nickmolo/ECE477/readme.MD

#Senior Design Project for Purdue ECE477
The following code is for a fabricated smart-watch for Senior design. Code in this repo is based off of various libraries including our own, such as the Adafruit Graphics Libraries for our SSD1351 display.

Midterm Design Review Presentation 
https://docs.google.com/presentation/d/1fQvJexct02s5zMMklutLdLCyOUqHS_1bk4CB7YSZFS4/edit?usp=sharing

Final Design Review Presentation
https://docs.google.com/presentation/d/1uoW5v5YpZROXi00Bag2v_5JE344Z9XPI0Cu_86e-bGs/edit?usp=sharing

Video!
https://www.youtube.com/watch?v=YeXBOrRXs24
