nickmolo/ECE477/Hardware/Images/Bluetooth.png

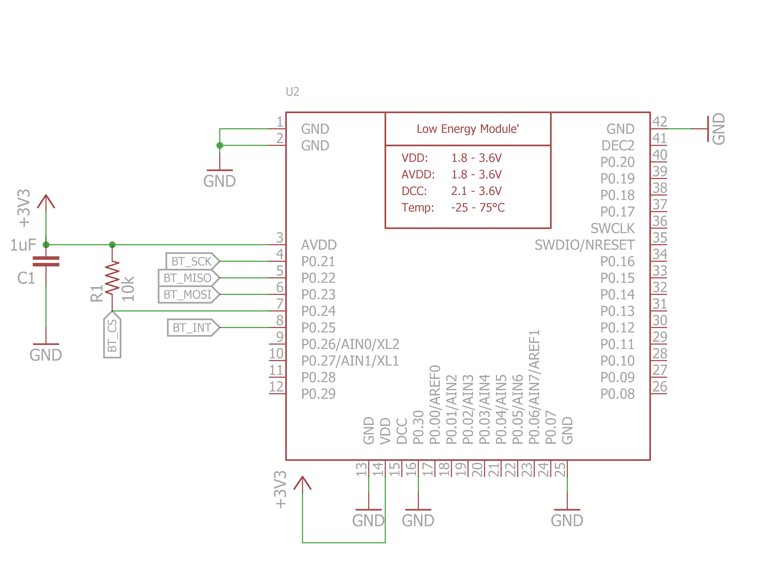
Hardware/Images/Bluetooth.png
