nickmolo/ECE477/Hardware/Images/Gesture.png

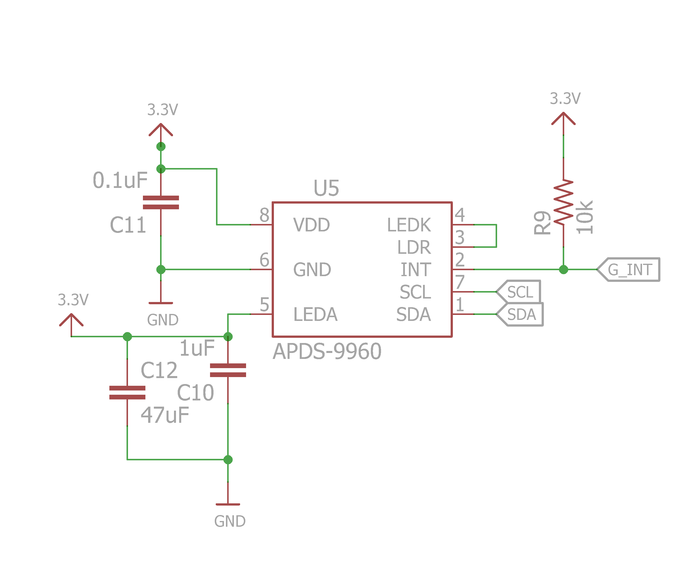
Hardware/Images/Gesture.png
