nickmolo/ECE477/Hardware/Images/IMU.png

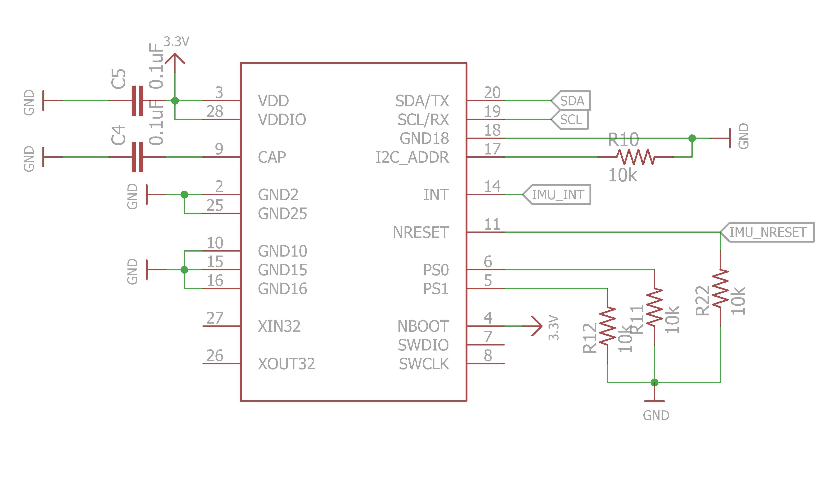
Hardware/Images/IMU.png
