nickmolo/ECE477/Hardware/Images/Microcontroller1.png

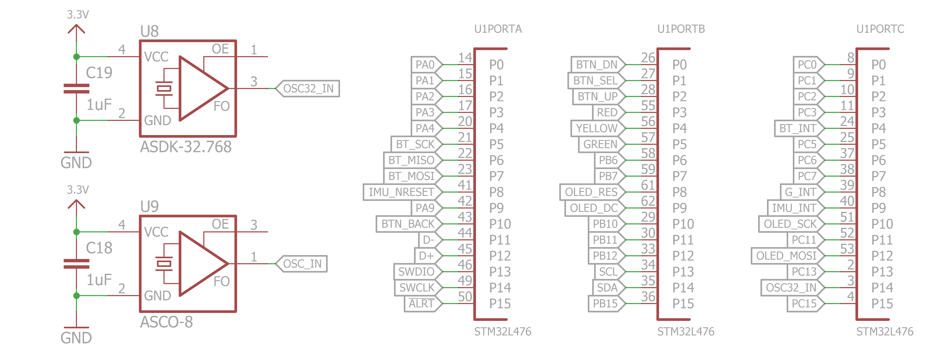
Hardware/Images/Microcontroller1.png
