nickmolo/ECE477/Hardware/Images/Microcontroller2.png

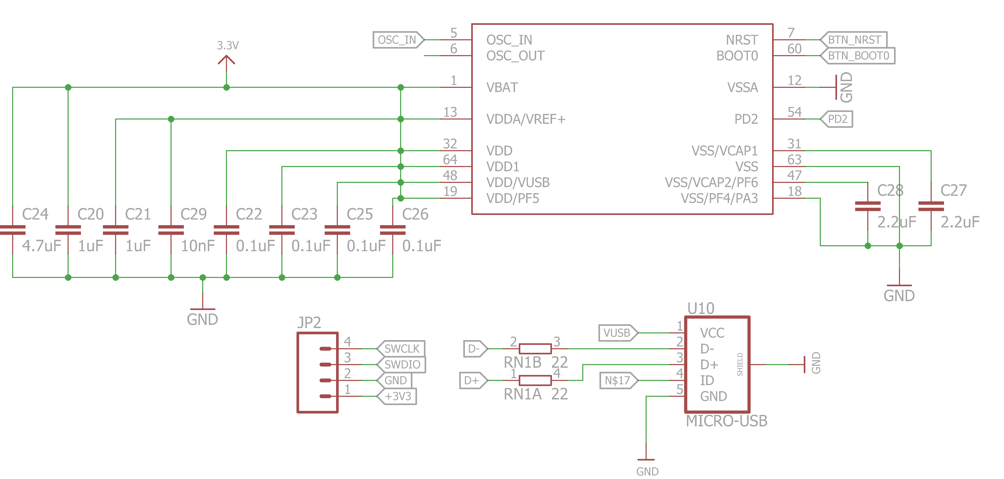
Hardware/Images/Microcontroller2.png
