nickmolo/ECE477/Hardware/Images/Microcontroller.png

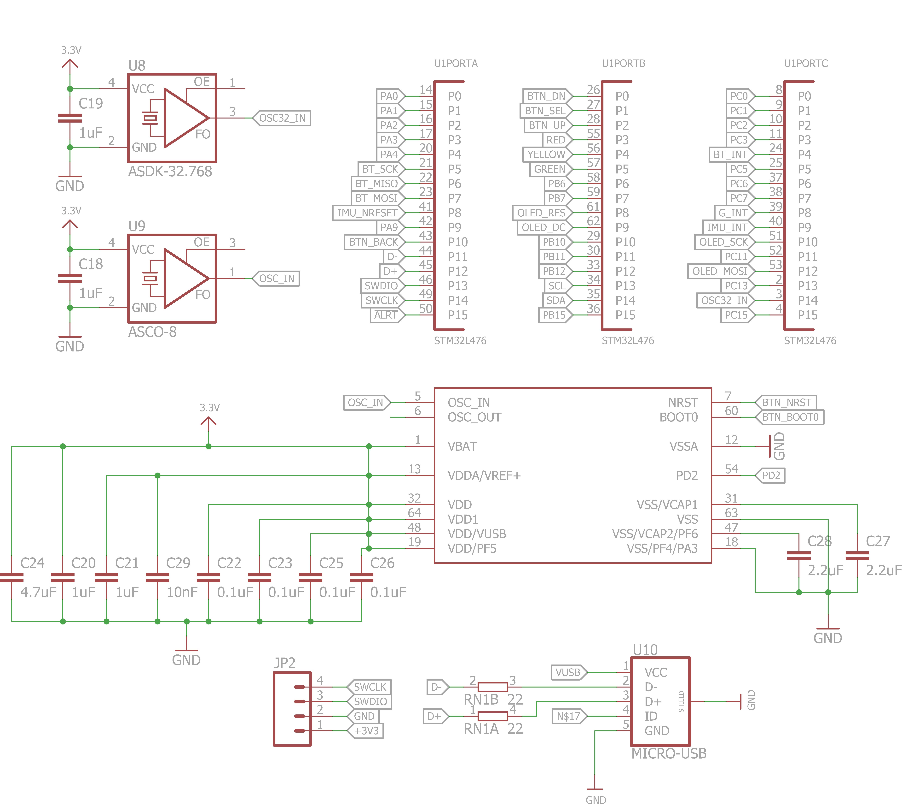
Hardware/Images/Microcontroller.png
