nickmolo/ECE477/Hardware/Images/MicroPinouts.PNG

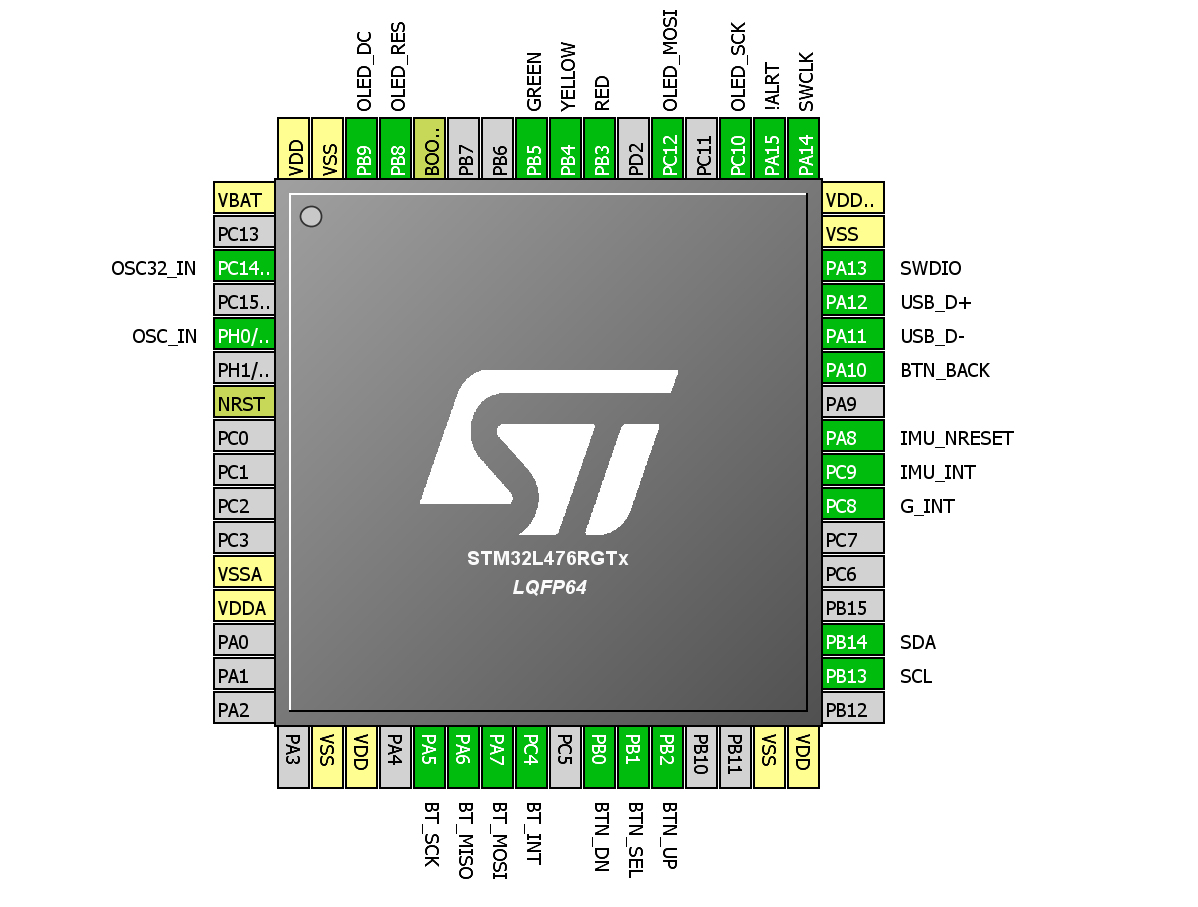
Hardware/Images/MicroPinouts.PNG
