nickmolo/ECE477/Hardware/Images/Misc.png

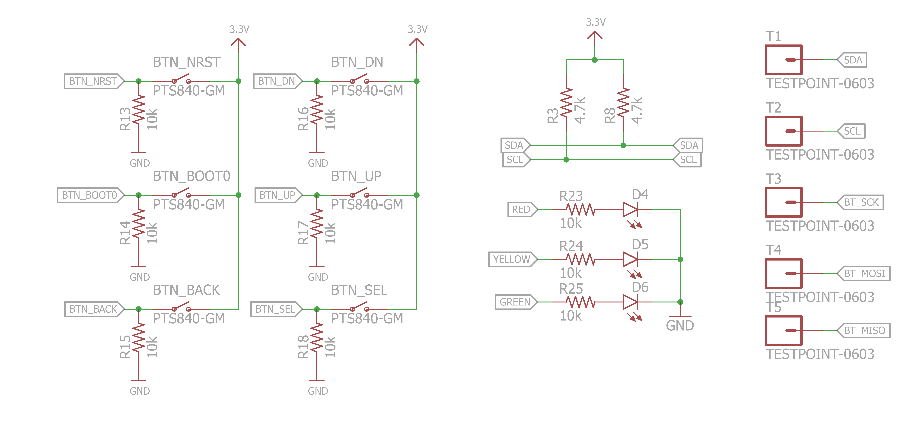
Hardware/Images/Misc.png
