nickmolo/ECE477/Hardware/Images/pcb.png

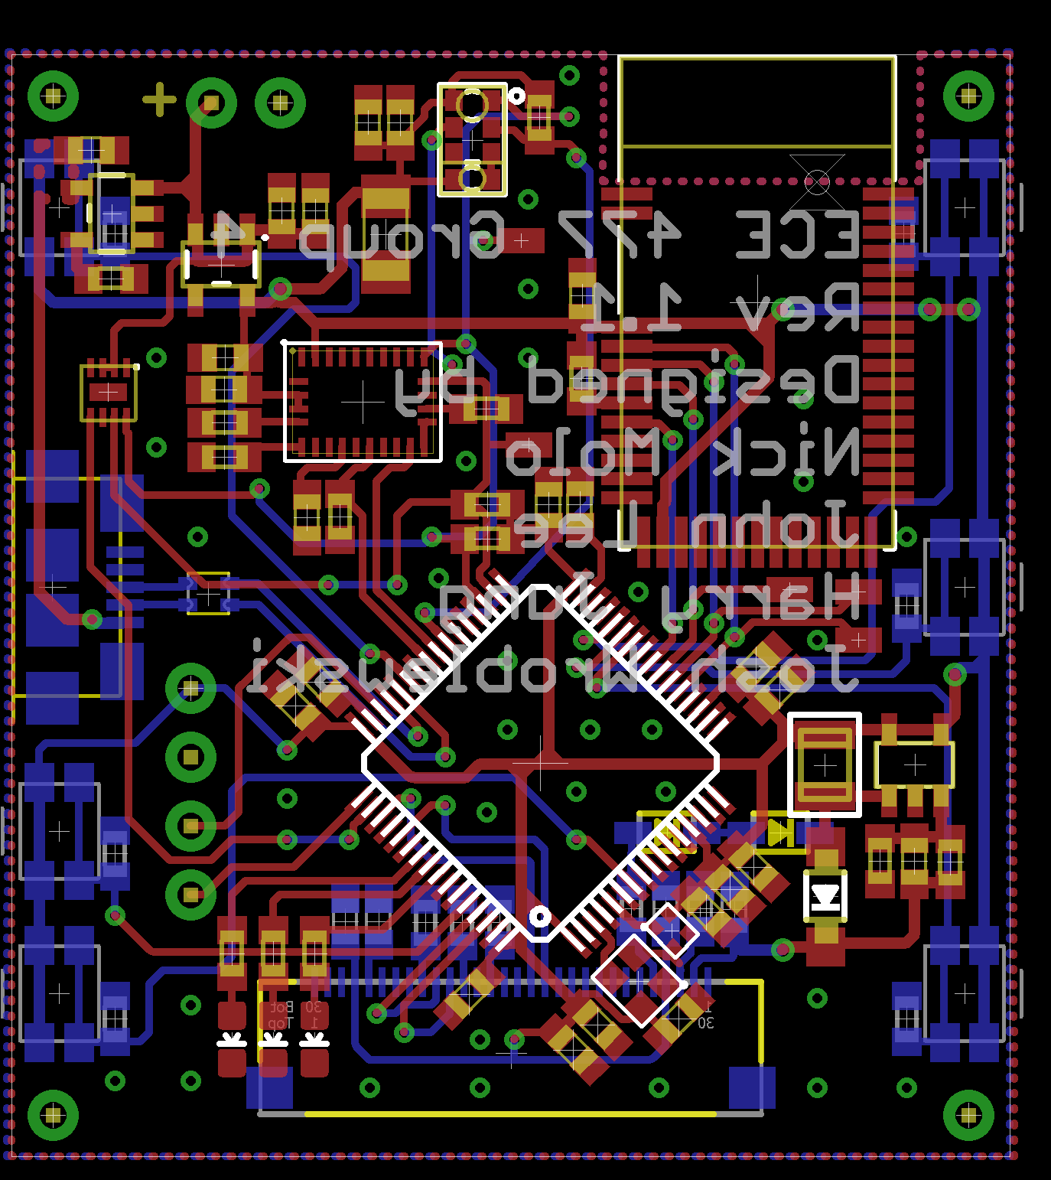
Hardware/Images/pcb.png
