nickmolo/ECE477/Hardware/Images/pcb_bot.png

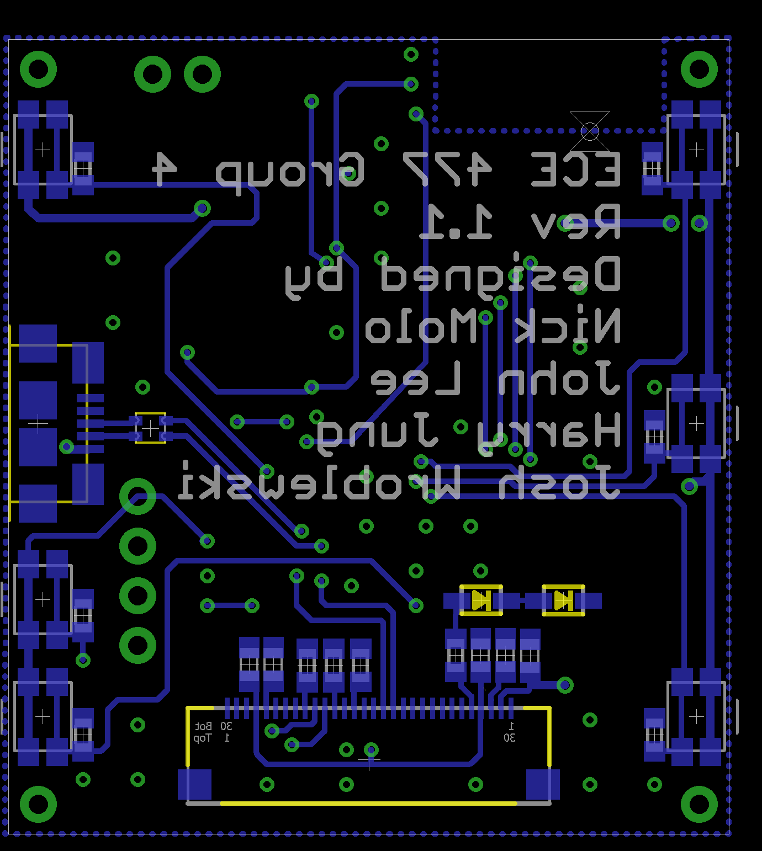
Hardware/Images/pcb_bot.png
