nickmolo/ECE477/Hardware/Images/pcb_top.png

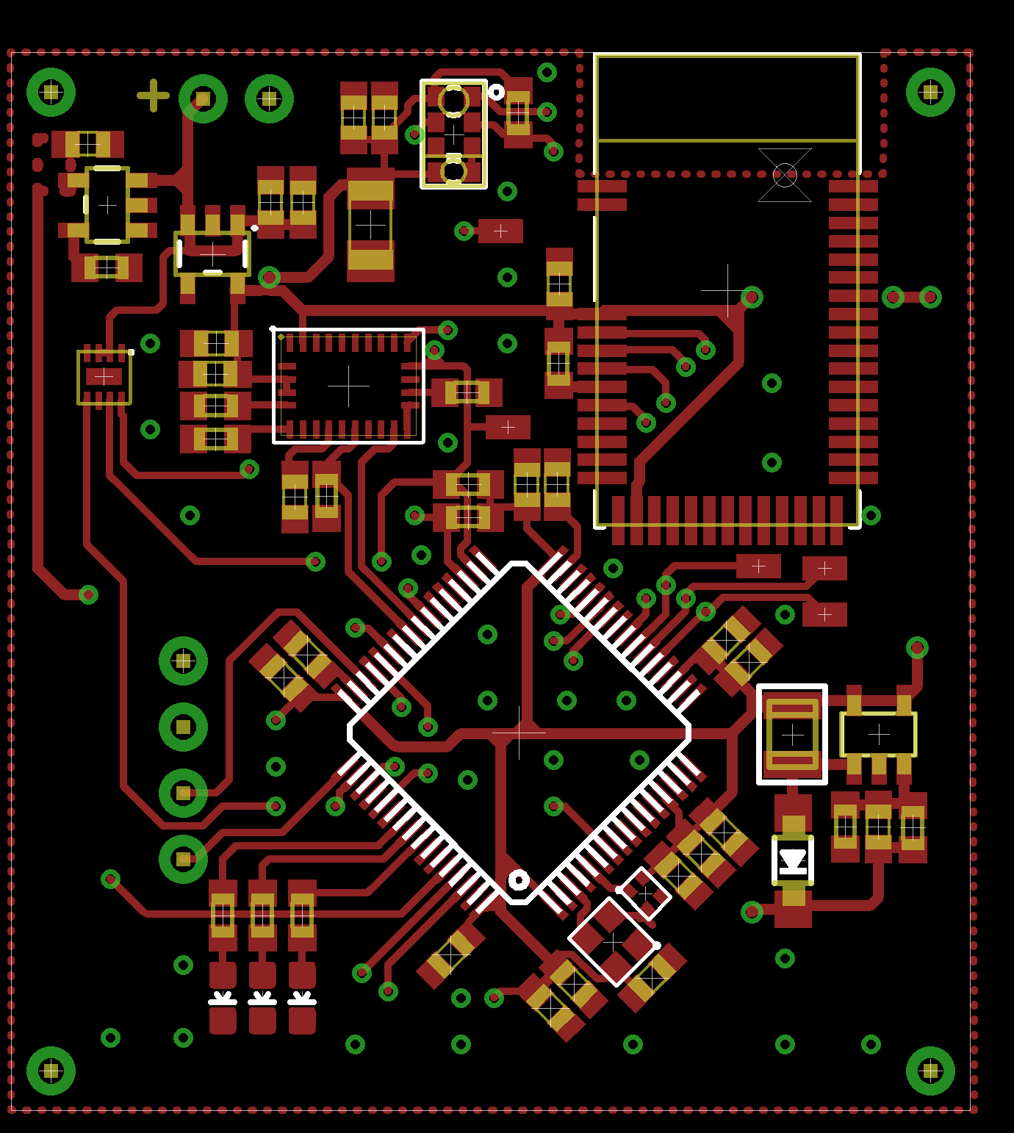
Hardware/Images/pcb_top.png
