nickmolo/ECE477/Hardware/Images/Power.png

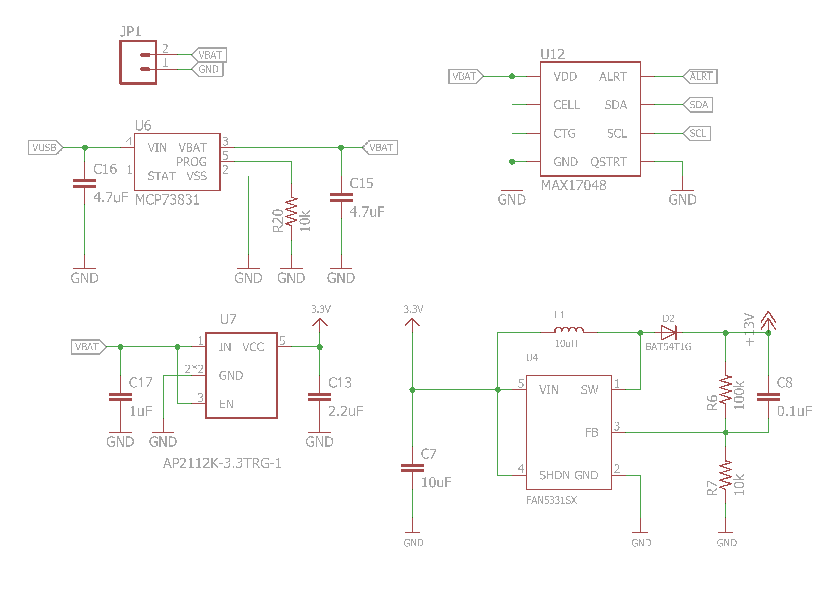
Hardware/Images/Power.png
