nickmolo/ECE477/Hardware/Images/Screen.png

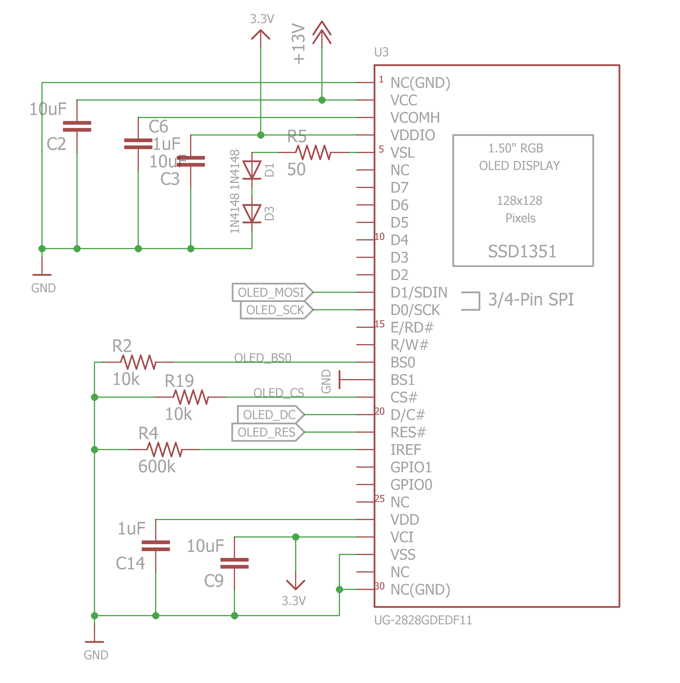
Hardware/Images/Screen.png
