nickmolo/ECE477/Hardware/BOM.xlsx

Qty | Qty x6 | Qty to Buy | Value | Device | Package | Parts | Description | Supplier | Part Number
6 | 36 | 40 | PTS840-GM | PTS840-GM | PTS840-GM | BTN_BACK, BTN_BOOT0, BTN_DN, BTN_NRST, BTN_SEL, BTN_UP | Button | Digikey | CKN10507CT-ND
8 | 48 | 100 | 1uF | C-EUC0603 | C0603 | C1, C3, C10, C14, C17, C18, C19, C20, C21 | Capacitor | Digikey | 445-1604-1-ND
1 | 6 | 10 | 47uF | C-EUC1206 | C1206 | C12 | Capacitor | Digikey | 587-1780-1-ND
3 | 18 | 30 | 2.2uF | C-EUC0603 | C0603 | C13, C27, C28 | Capacitor | Digikey | 1276-1188-1-ND
3 | 18 | 100 | 4.7uF | C-EUC0603 | C0603 | C15, C16, C24 | Capacitor | Digikey | 1276-2087-1-ND
4 | 24 | 30 | 10uF | C-EUC0603 | C0603 | C2, C6, C7, C9 | Capacitor | Digikey | 445-9065-1-ND
1 | 6 | 10 | 10nF | C-EUC0603 | C0603 | C29 | Capacitor | Digikey | 445-1304-1-ND
8 | 48 | 100 | 0.1uF | C-EUC0603 | C0603 | C4, C5, C8, C11, C22, C23, C25, C26 | Capacitor | Digikey | 1276-1936-1-ND
2 | 12 | 20 | 1N4148 | DIODESOD-323 | SOD-323 | D1, D3 | Diode | Digikey | 1N4148WFL-G3-08GICT-ND
1 | 6 | 10 | BAT54T1G | DIODESOD-123 | SOD-123 | D2 | Diode | Digikey | BAT54T1GOSCT-ND
1 | 6 |  |  | M02PTH | 1X02 | JP1 | Standard 2-pin 0.1 " | Digikey
1 | 6 | 10 | 10uH | INDUCTOR | INDUCTOR_1007 | L1 | Inductors | Digikey | 587-1936-1-ND
17 | 102 | 500 | 10k | R-US_R0603 | R0603 | R1, R2, R7, R9, R10, R11, R12, R13, R14, R15, R16, R17, R18, R19, R20, R21, R22 | Resistor | Digikey | P10KGCT-ND50
2 | 12 | 100 | 4.7k | R-US_R0603 | R0603 | R3, R8 | Resistor | Digikey | P4.7KGCT-ND
1 | 6 | 50 | 600k | R-US_R0603 | R0603 | R4 | Resistor | Digikey | P604KHCT-ND
1 | 6 | 50 | 50 | R-US_R0603 | R0603 | R5 | Resistor | Digikey | P49.9HCT-ND
1 | 6 | 50 | 100k | R-US_R0603 | R0603 | R6 | Resistor | Digikey | P100KGCT-ND
1 | 6 | 10 | 22 | 2R-NEXBV4V | EXBV4V | RN1 | Array Chip Resistor | Digikey | Y2220CT-ND
1 | 6 | 5 | STM32L476 | STM32L476 | TQFP64-10X10 | U1 | Micro Controller | Digikey | 497-15877-ND
1 | 6 | 10 | MICRO-USB | MICRO-USB | MICRO-USB | U10 | USB Connector | Digikey | 609-4613-1-ND
1 | 6 |  | BNO055 | BNO055 | LGA28 | U11 | IMU | Mouser | 262-BNO055
1 | 6 |  |  | NRF51822_MODULE_MDBT40 | BLE_MODULE_RAYTAC_MDBT40 | U2 | nRF51822 Bluetooth | Adafruit | 2633
1 | 6 |  | UG-2828GDEDF11 | DISP_OLED_UG-2828GDEDF11BOTTOM | FPC_XF2M-3015-1A | U3 | OLED Display + zif!!! | BuyDisplay | ER-OLED015-1C
1 | 6 | 10 | FAN5331SX | FAN5331 | SOT23-5$1 | U4 | Boost Converter | Digikey | FAN5331SXCT-ND
1 | 6 | 5 | APDS-9960 | APDS-9960 | APDS-9960 | U5 | Gesture Sensor | Mouser | 630-APDS-9960
1 | 6 | 10 | MCP73831 | MCP73831 | SOT23-5 | U6 | Battery Charger | Digikey | MCP73831T-2ACI/OTCT-ND
1 | 6 | 10 | AP2112K-3.3TRG-1 | LDO-TPS78233 | SOT23-5 | U7 | Voltage Regulator | Digikey | AP2112K-3.3TRG1DICT-ND
1 | 6 | 6 | ASDK-32.768 | ASDK-32.768 | ASDK-32.768 | U8 | Oscillator | Digikey | 535-9999-1-ND
1 | 6 | 6 | ASCO-8 | ASCO-8 | ASCO-8 | U9 | Oscillator | Digikey | 535-12077-1-ND
5 | 30 | 30 |  | Test Point | 603 | T1, T2, T3, T4, T5 | Test point | Digikey | 571-1625854-3
5 | 30 |  |  | MAX17048G | TDFN-8 | U12 | Battery Monitor | Mouser | 700-MAX17048G+
3 | 18 |  | 82 | Resistor | 603 | R23, R24, R25 | Resistor | Digikey | P82GCT-ND
1 | 6 |  | RED | LED | 603 | D4 | Red LED | Digikey | 475-2506-1-ND
1 | 6 |  | YELLOW | LED | 603 | D5 | Yellow LED | Digikey | 475-1196-1-ND
1 | 6 |  | GREEN | LED | 603 | D6 | Green LED | Digikey | 475-2709-1-ND
