nickmolo/ECE477/Hardware/SmartWatch/SmartWatch.dxf

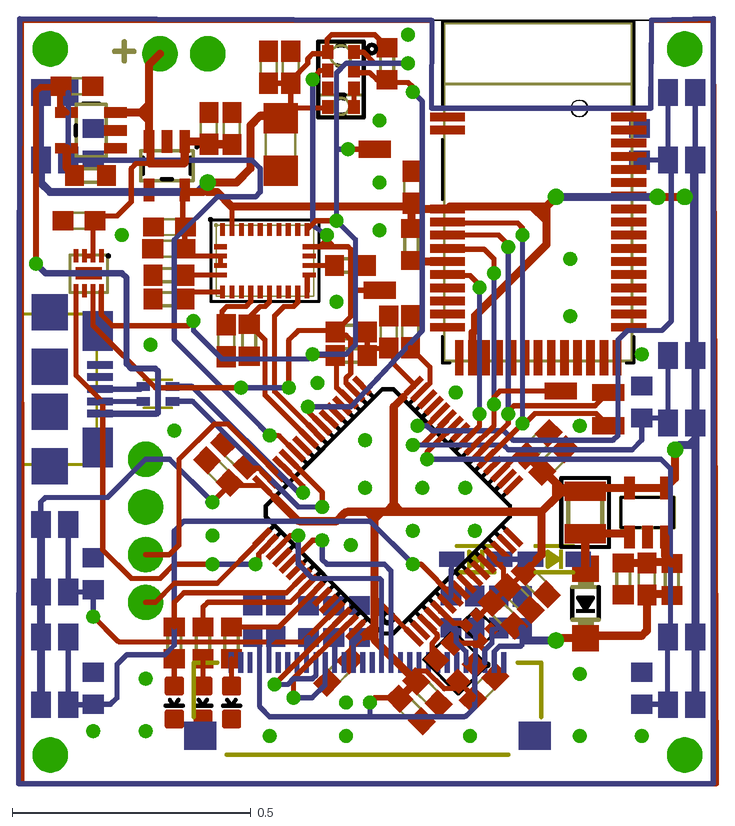
[picture p18: CAD file, 2015-12-07]
Hardware/SmartWatch/SmartWatch.dxf
1.47 x 1.61
