nickmolo/ECE477/Hardware/SmartWatch/SmartWatch.pdf

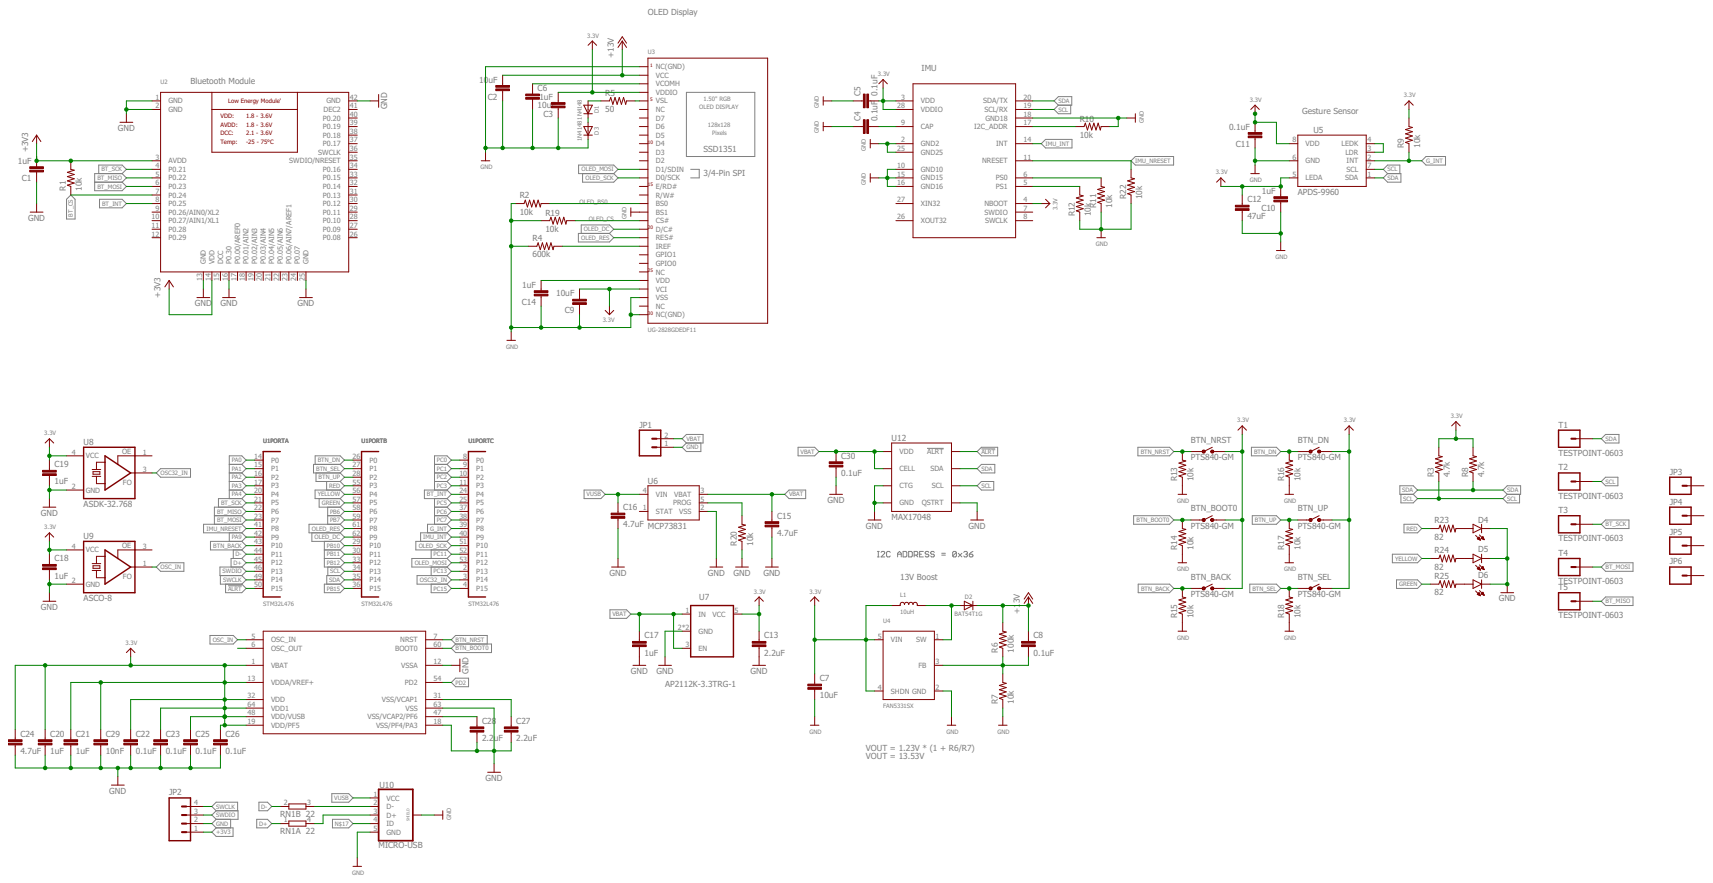
[picture p19: page 1]

Gesture Sensor 1.50" RGB OLED DISPLAY
