nickmolo/ECE477/Hardware/SmartWatch/SmartWatch.brd

## EAGLE design Hardware/SmartWatch/SmartWatch.brd (2015-10-23)

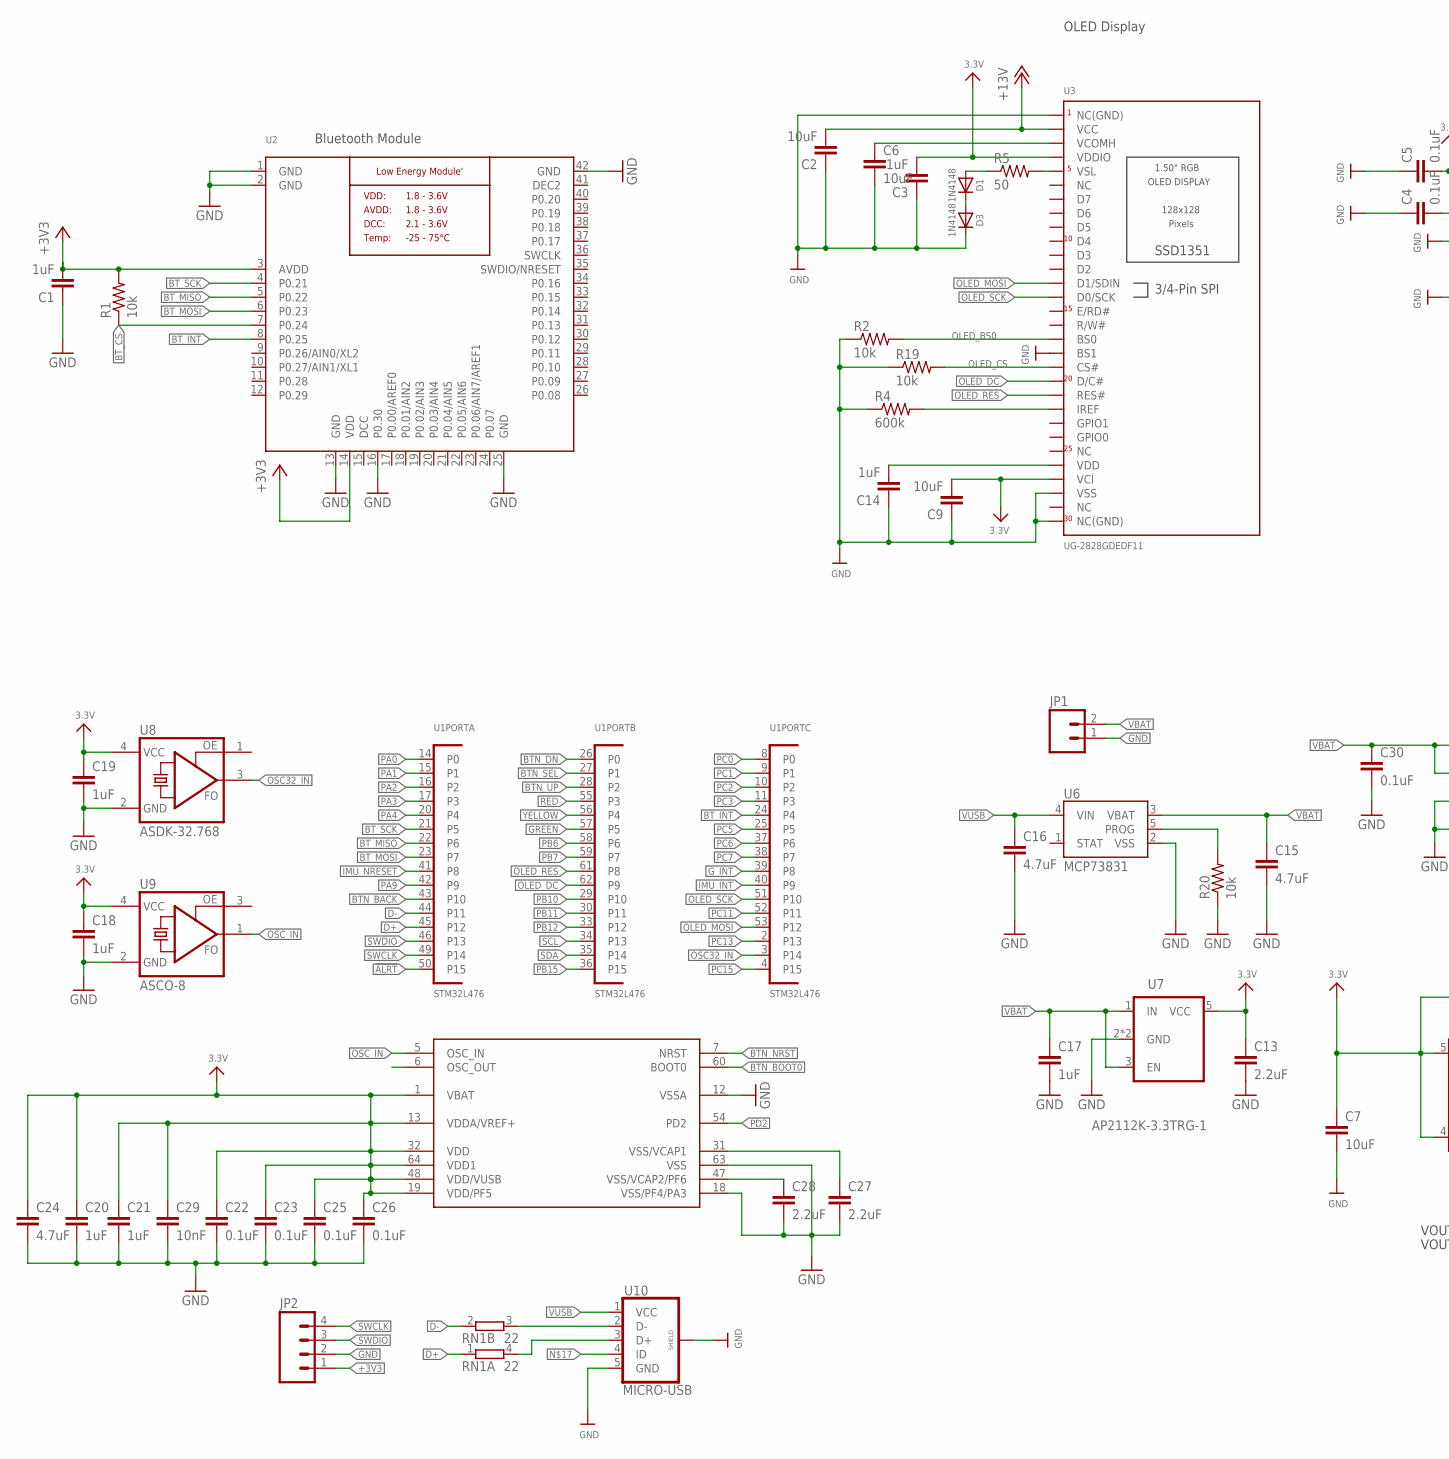
[picture p20: schematic SmartWatch.sch, part in row 1, column 1]

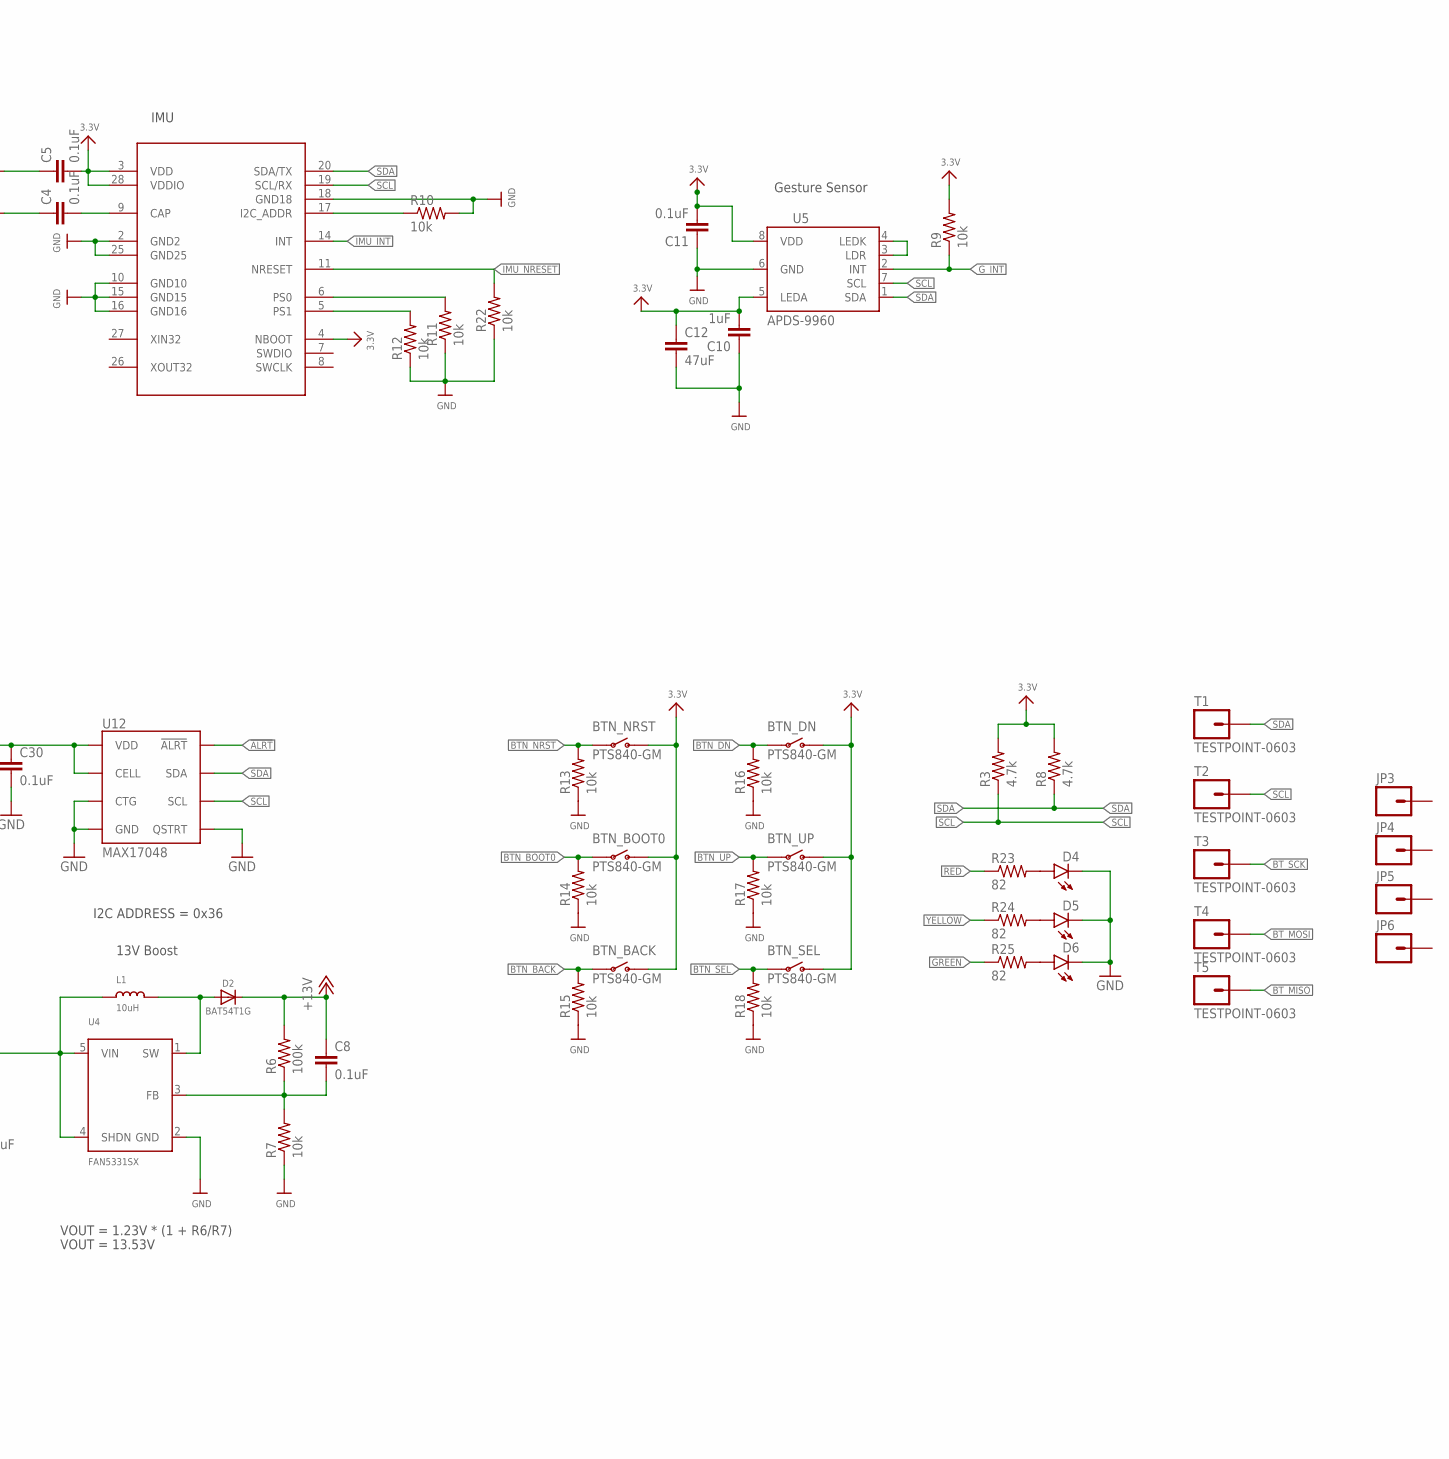
[picture p21: schematic SmartWatch.sch, part in row 1, column 2]

Parts:
BTN_BACK: PTS840-GM
BTN_BOOT0: PTS840-GM
BTN_DN: PTS840-GM
BTN_NRST: PTS840-GM
BTN_SEL: PTS840-GM
BTN_UP: PTS840-GM
C1, C3, C10, C14, C17, C18, C19, C20, C21: 1uF; C0603
C2, C6, C7, C9: 10uF; C0603
C4, C5, C8, C11, C22, C23, C25, C26, C30: 0.1uF; C0603
C12: 47uF; C1206
C13, C27, C28: 2.2uF; C0603
C15, C16, C24: 4.7uF; C0603
C29: 10nF; C0603
D1, D3: 1N4148; SOD-323
D2: BAT54T1G; SOD-123
D4, D5, D6: LED0603; LED-0603
JP1: M021X02_NO_SILK; 1X02_NO_SILK
JP2: M04NO_SILK_ALL_ROUND; 1X04_NO_SILK_ALL_ROUND
JP3, JP4, JP5, JP6: M01PTH_NO_SILK_YES_STOP; 1X01_NO_SILK
L1: 10uH; INDUCTOR_1007
R1, R2, R7, R9, R10, R11, R12, R13, R14, R15, R16, R17, R18, R19, R20, R22: 10k; R0603
R3, R8: 4.7k; R0603
R4: 600k; R0603
R5: 50; R0603
R6: 100k; R0603
R23, R24, R25: 82; R0603
RN1: 22; EXBV4V
T1, T2, T3, T4, T5: TESTPOINT-0603
U1: STM32L476; TQFP64-10X10
U2: NRF51822_MODULE_MDBT40; BLE_MODULE_RAYTAC_MDBT40
U3: UG-2828GDEDF11; FPC_XF2M-3015-1A
U4: FAN5331SX; SOT23-5$1
U5: APDS-9960
U6: MCP73831; SOT23-5
U7: AP2112K-3.3TRG-1; SOT23-5
U8: ASDK-32.768
U9: ASCO-8
U10: MICRO-USB
U11: BNO055; LGA28
U12: MAX17048; DFN-8

Connections:
13V: C2.2, C8.1, D2.C, R6.2, U3.P$2 (VCC)
!ALRT: U1.50 (P15), U12.P$5 (!ALRT)
+3V3: BTN_BACK.3 (34), BTN_BACK.4 (34), BTN_BOOT0.3 (34), BTN_BOOT0.4 (34), BTN_DN.3 (34), BTN_DN.4 (34), BTN_NRST.3 (34), BTN_NRST.4 (34), BTN_SEL.3 (34), BTN_SEL.4 (34), BTN_UP.3 (34), BTN_UP.4 (34), C1.2, C3.2, C5.2, C7.1, C9.2, C10.2, C11.2, C12.1, C13.1, C18.1, C19.1, C20.1, C21.1, C22.1, C23.1, C24.1, C25.1, C26.1, C29.1, JP2.1, L1.P$1 (1), R1.2, R3.2, R8.2, R9.2, U1.1 (VBAT), U1.13 (VDDA/VREF+), U1.19 (VDD/PF5), U1.32 (VDD), U1.48 (VDD/VUSB), U1.64 (VDD1), U2.3 (AVDD), U2.14 (VDD), U3.P$4 (VDDIO), U3.P$27 (VCI), U4.4 (SHDN), U4.5 (VIN), U5.5 (LEDA), U5.8 (VDD), U7.5 (VCC), U8.4 (VCC), U9.4 (VCC), U11.3 (VDD), U11.4 (NBOOT), U11.28 (VDDIO)
BTN_BACK: BTN_BACK.1 (12), BTN_BACK.2 (12), R15.2, U1.43 (P10)
BTN_BOOT0: BTN_BOOT0.1 (12), BTN_BOOT0.2 (12), R14.2, U1.60 (BOOT0)
BTN_DN: BTN_DN.1 (12), BTN_DN.2 (12), R16.2, U1.26 (P0)
BTN_NRST: BTN_NRST.1 (12), BTN_NRST.2 (12), R13.2, U1.7 (NRST)
BTN_SEL: BTN_SEL.1 (12), BTN_SEL.2 (12), R18.2, U1.27 (P1)
BTN_UP: BTN_UP.1 (12), BTN_UP.2 (12), R17.2, U1.28 (P2)
BT_CS: R1.1, U2.7 (P0.24)
BT_INT: U1.24 (P4), U2.8 (P0.25)
BT_MISO: T5.1, U1.22 (P6), U2.5 (P0.22)
BT_MOSI: T4.1, U1.23 (P7), U2.6 (P0.23)
BT_SCK: T3.1, U1.21 (P5), U2.4 (P0.21)
D+: RN1.1, U1.45 (P12)
D-: RN1.2 (1), U1.44 (P11)
DCC: U2.15 (DCC)
DEC2: U2.41 (DEC2)
GND: C1.1, C2.1, C3.1, C4.1, C5.1, C6.2, C7.2, C9.1, C10.1, C11.1, C12.2, C13.2, C14.1, C15.2, C16.2, C17.2, C18.2, C19.2, C20.2, C21.2, C22.2, C23.2, C24.2, C25.2, C26.2, C27.2, C28.2, C29.2, C30.2, D3.C, D4.C, D5.C, D6.C, JP1.1, JP2.2, R2.1, R4.1, R7.1, R10.2, R11.1, R12.1, R13.1, R14.1, R15.1, R16.1, R17.1, R18.1, R19.1, R20.1, R22.1, U1.12 (VSSA), U1.18 (VSS/PF4/PA3), U1.63 (VSS), U2.1 (GND), U2.2 (GND), U2.13 (GND), U2.16 (P0.30), U2.25 (GND), U2.42 (GND), U3.P$1 (NC(GND)), U3.P$18 (BS1), U3.P$28 (VSS), U3.P$30 (NC(GND)), U4.2 (GND), U5.6 (GND), U6.2 (VSS), U7.2 (GND), U7.4 (GND), U8.2 (GND), U9.2 (GND), U10.5 (GND), U10.6 (SHIELD), U10.7 (SHIELD), U10.8 (SHIELD), U10.9 (SHIELD), U10.10 (SHIELD), U10.11 (SHIELD), U11.2 (GND2), U11.10 (GND10), U11.15 (GND15), U11.16 (GND16), U11.18 (GND18), U11.25 (GND25), U12.P$1 (CTG), U12.P$4 (GND), U12.P$6 (QSTRT), U12.P$9 (GND)
GREEN: R25.1, U1.57 (P5)
G_INT: R9.1, U1.39 (P8), U5.2 (INT)
ID: RN1.4 (2), U10.3 (D+)
IMU_INT: U1.40 (P9), U11.14 (INT)
IMU_NRESET: R22.2, U1.41 (P8), U11.11 (NRESET)
unnamed: R4.2, U3.P$22 (IREF)
unnamed: C14.2, U3.P$26 (VDD)
unnamed: R10.1, U11.17 (I2C_ADDR)
unnamed: C4.2, U11.9 (CAP)
unnamed: D2.A, L1.P$2 (2), U4.1 (SW)
unnamed: R5.2, U3.P$5 (VSL)
unnamed: D1.A, R5.1
unnamed: C8.2, R6.1, R7.2, U4.3 (FB)
unnamed: U5.3 (LDR), U5.4 (LEDK)
unnamed: RN1.3 (2), U10.2 (D-)
unnamed: D1.C, D3.A
unnamed: R12.2, U11.5 (PS1)
unnamed: R11.2, U11.6 (PS0)
unnamed: D4.A, R23.2
unnamed: D5.A, R24.2
unnamed: D6.A, R25.2
unnamed: C27.1, U1.31 (VSS/VCAP1)
unnamed: C28.1, U1.47 (VSS/VCAP2/PF6)
OLED_BS0: R2.2, U3.P$17 (BS0)
OLED_CS: R19.2, U3.P$19 (CS#)
OLED_DC: U1.62 (P9), U3.P$20 (D/C#)
OLED_MOSI: U1.53 (P12), U3.P$13 (D1/SDIN)
OLED_RES: U1.61 (P8), U3.P$21 (RES#)
OLED_SCK: U1.51 (P10), U3.P$14 (D0/SCK)
OSC32_IN: U1.3 (P14), U8.3 (FO)
OSC_IN: U1.5 (OSC_IN), U9.1 (FO)
PA0: U1.14 (P0)
PA1: U1.15 (P1)
PA2: U1.16 (P2)
PA3: U1.17 (P3)
PA4: U1.20 (P4)
PA9: U1.42 (P9)
PB6: U1.58 (P6)
PB7: U1.59 (P7)
PB10: U1.29 (P10)
PB11: U1.30 (P11)
PB12: U1.33 (P12)
PB15: U1.36 (P15)
PC0: U1.8 (P0)
PC1: U1.9 (P1)
PC2: U1.10 (P2)
PC3: U1.11 (P3)
PC5: U1.25 (P5)
PC6: U1.37 (P6)
PC7: U1.38 (P7)
PC11: U1.52 (P11)
PC13: U1.2 (P13)
PC15: U1.4 (P15)
PD2: U1.54 (PD2)
PROG: R20.2, U6.5 (PROG)
RED: R23.1, U1.55 (P3)
SCL: R3.1, T2.1, U1.34 (P13), U5.7 (SCL), U11.19 (SCL/RX), U12.P$7 (SCL)
SDA: R8.1, T1.1, U1.35 (P14), U5.1 (SDA), U11.20 (SDA/TX), U12.P$8 (SDA)
SWCLK: JP2.4, U1.49 (P14)
SWDIO: JP2.3, U1.46 (P13)
VBAT: C15.1, C17.1, C30.1, JP1.2, U6.3 (VBAT), U7.1 (IN), U7.3 (EN), U12.P$2 (CELL), U12.P$3 (VDD)
VCOMH1: C6.1, U3.P$3 (VCOMH)
VUSB: C16.1, U6.4 (VIN), U10.1 (VCC)
YELLOW: R24.1, U1.56 (P4)

Notes on the sheet:
VOUT = 1.23V * (1 + R6/R7)
VOUT = 13.53V
13V Boost
OLED Display
Bluetooth Module
IMU
Gesture Sensor
I2C ADDRESS = 0x36

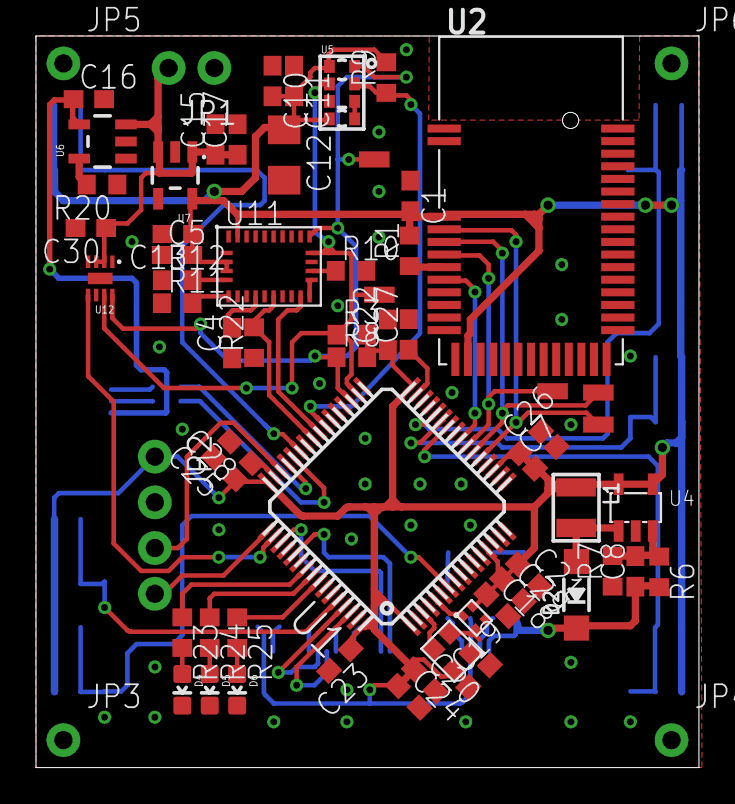
[picture p22: board SmartWatch.brd from above]

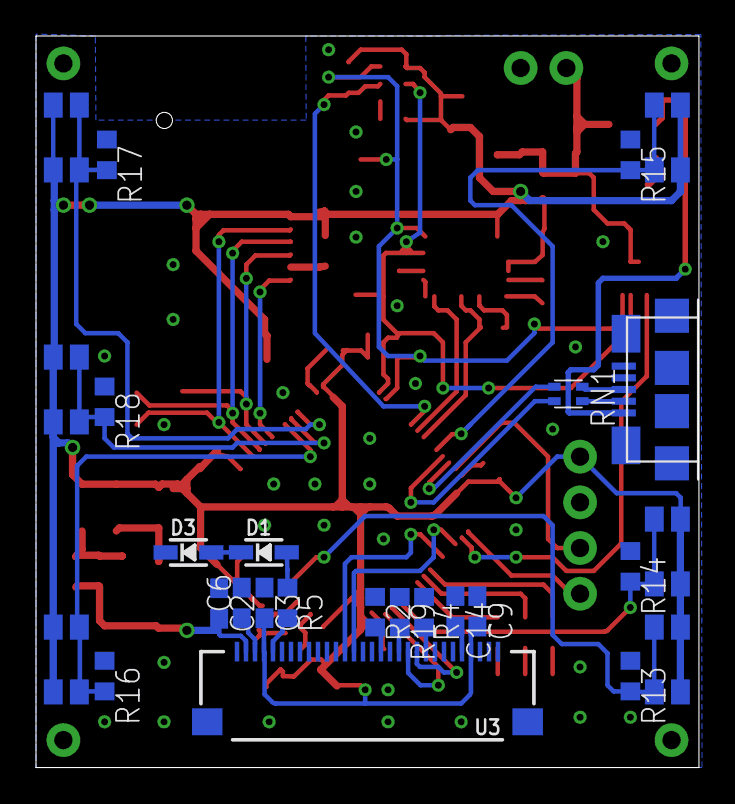
[picture p23: board SmartWatch.brd from below]

Board: 2 copper layers, 36.8 x 40.6 mm, 91 parts (26 on the bottom side), 58 nets.
