nickmolo/ECE477/Software/SmartWatch/SmartWatch.ioc

Mcu.UserName=STM32L476RGTx
PA10.GPIO_Label=BTN_BACK
PA10.Signal=GPIO_Input
PA11.GPIO_Label=USB_D-
PA11.Signal=USB_OTG_FS_DM
PA12.GPIO_Label=USB_D+
PA12.Signal=USB_OTG_FS_DP
PA13.GPIO_Label=SWDIO
PA13.Signal=SYS_JTMS-SWDIO
PA14.GPIO_Label=SWCLK
PA14.Signal=SYS_JTCK-SWCLK
PA15.GPIO_Label=\!ALRT
PA15.Signal=GPIO_Input
PA5.GPIO_Label=BT_SCK
PA5.Signal=SPI1_SCK
PA6.GPIO_Label=BT_MISO
PA6.Signal=SPI1_MISO
PA7.GPIO_Label=BT_MOSI
PA7.Signal=SPI1_MOSI
PA8.GPIO_Label=IMU_NRESET
PA8.Signal=GPIO_Output
PB0.GPIO_Label=BTN_DN
PB0.Signal=GPIO_Input
PB1.GPIO_Label=BTN_SEL
PB1.Signal=GPIO_Input
PB13.GPIO_Label=SCL
PB13.Signal=I2C2_SCL
PB14.GPIO_Label=SDA
PB14.Signal=I2C2_SDA
PB2.GPIO_Label=BTN_UP
PB2.Signal=GPIO_Input
PB3.GPIO_Label=RED
PB3.Signal=GPIO_Output
PB4.GPIO_Label=YELLOW
PB4.Signal=GPIO_Output
PB5.GPIO_Label=GREEN
PB5.Signal=GPIO_Output
PB8.GPIO_Label=OLED_RES
PB8.Signal=GPIO_Output
PB9.GPIO_Label=OLED_DC
PB9.Signal=GPIO_Output
PC10.GPIO_Label=OLED_SCK
PC10.Signal=SPI3_SCK
PC12.GPIO_Label=OLED_MOSI
PC12.Signal=SPI3_MOSI
PC14/OSC32_IN.GPIO_Label=OSC32_IN
PC14/OSC32_IN.Signal=RCC_OSC32_IN
PC15/OSC32_OUT.Signal=RCC_OSC32_OUT
PC4.GPIO_Label=BT_INT
PC4.Signal=GPIO_Input
PC8.GPIO_Label=G_INT
PC8.Signal=GPIO_Input
PC9.GPIO_Label=IMU_INT
PC9.Signal=GPIO_Input
PH0/OSC_IN.GPIO_Label=OSC_IN
PH0/OSC_IN.Signal=RCC_OSC_IN
PH1/OSC_OUT.Signal=RCC_OSC_OUT
