nickmolo/ECE477/Software/display/mbed-src/targets/hal/TARGET_STM/TARGET_STM32F0/TARGET_NUCLEO_F091RC/PeripheralPins.c

/* mbed Microcontroller Library
 *******************************************************************************
 * Copyright (c) 2014, STMicroelectronics
 * All rights reserved.
 *
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
 * THIS SOFTWARE IS PROVIDED BY THE COPYRIGHT HOLDERS AND CONTRIBUTORS "AS IS"
 * AND ANY EXPRESS OR IMPLIED WARRANTIES, INCLUDING, BUT NOT LIMITED TO, THE
 * IMPLIED WARRANTIES OF MERCHANTABILITY AND FITNESS FOR A PARTICULAR PURPOSE ARE
 * DISCLAIMED. IN NO EVENT SHALL THE COPYRIGHT HOLDER OR CONTRIBUTORS BE LIABLE
 * FOR ANY DIRECT, INDIRECT, INCIDENTAL, SPECIAL, EXEMPLARY, OR CONSEQUENTIAL
 * DAMAGES (INCLUDING, BUT NOT LIMITED TO, PROCUREMENT OF SUBSTITUTE GOODS OR
 * SERVICES; LOSS OF USE, DATA, OR PROFITS; OR BUSINESS INTERRUPTION) HOWEVER
 * CAUSED AND ON ANY THEORY OF LIABILITY, WHETHER IN CONTRACT, STRICT LIABILITY,
 * OR TORT (INCLUDING NEGLIGENCE OR OTHERWISE) ARISING IN ANY WAY OUT OF THE USE
 * OF THIS SOFTWARE, EVEN IF ADVISED OF THE POSSIBILITY OF SUCH DAMAGE.
 *******************************************************************************
 */

#include "PeripheralPins.h"

// =====
// Note: Commented lines are alternative possibilities which are not used per default.
//       If you change them, you will have also to modify the corresponding xxx_api.c file
//       for pwmout, analogin, analogout, ...
// =====

//*** ADC ***

const PinMap PinMap_ADC[] = {
    {PA_0, ADC_1, STM_PIN_DATA(STM_MODE_ANALOG, GPIO_NOPULL, 0)}, // ADC1_IN0
    {PA_1, ADC_1, STM_PIN_DATA(STM_MODE_ANALOG, GPIO_NOPULL, 0)}, // ADC1_IN1
    {PA_2, ADC_1, STM_PIN_DATA(STM_MODE_ANALOG, GPIO_NOPULL, 0)}, // ADC1_IN2
    {PA_3, ADC_1, STM_PIN_DATA(STM_MODE_ANALOG, GPIO_NOPULL, 0)}, // ADC1_IN3
    {PA_4, ADC_1, STM_PIN_DATA(STM_MODE_ANALOG, GPIO_NOPULL, 0)}, // ADC1_IN4
    {PA_5, ADC_1, STM_PIN_DATA(STM_MODE_ANALOG, GPIO_NOPULL, 0)}, // ADC1_IN5
    {PA_6, ADC_1, STM_PIN_DATA(STM_MODE_ANALOG, GPIO_NOPULL, 0)}, // ADC1_IN6
    {PA_7, ADC_1, STM_PIN_DATA(STM_MODE_ANALOG, GPIO_NOPULL, 0)}, // ADC1_IN7
    {PB_0, ADC_1, STM_PIN_DATA(STM_MODE_ANALOG, GPIO_NOPULL, 0)}, // ADC1_IN8
    {PB_1, ADC_1, STM_PIN_DATA(STM_MODE_ANALOG, GPIO_NOPULL, 0)}, // ADC1_IN9
    {PC_0, ADC_1, STM_PIN_DATA(STM_MODE_ANALOG, GPIO_NOPULL, 0)}, // ADC1_IN10
    {PC_1, ADC_1, STM_PIN_DATA(STM_MODE_ANALOG, GPIO_NOPULL, 0)}, // ADC1_IN11
    {PC_2, ADC_1, STM_PIN_DATA(STM_MODE_ANALOG, GPIO_NOPULL, 0)}, // ADC1_IN12
    {PC_3, ADC_1, STM_PIN_DATA(STM_MODE_ANALOG, GPIO_NOPULL, 0)}, // ADC1_IN13
    {PC_4, ADC_1, STM_PIN_DATA(STM_MODE_ANALOG, GPIO_NOPULL, 0)}, // ADC1_IN14
    {PC_5, ADC_1, STM_PIN_DATA(STM_MODE_ANALOG, GPIO_NOPULL, 0)}, // ADC1_IN15
    {NC,   NC,    0}
};

//*** DAC ***

const PinMap PinMap_DAC[] = {
    {PA_4, DAC_1, STM_PIN_DATA(STM_MODE_ANALOG, GPIO_NOPULL, 0)}, // DAC_OUT1
    {PA_5, DAC_1, STM_PIN_DATA(STM_MODE_ANALOG, GPIO_NOPULL, 0)}, // DAC_OUT2 (Warning: LED1 is also on this pin)
    {NC,   NC,    0}
};

//*** I2C ***

const PinMap PinMap_I2C_SDA[] = {
    {PA_10, I2C_1, STM_PIN_DATA(STM_MODE_AF_OD, GPIO_NOPULL, GPIO_AF4_I2C1)},
    {PA_12, I2C_2, STM_PIN_DATA(STM_MODE_AF_OD, GPIO_NOPULL, GPIO_AF5_I2C2)},
    {PB_7,  I2C_1, STM_PIN_DATA(STM_MODE_AF_OD, GPIO_NOPULL, GPIO_AF1_I2C1)},
    {PB_9,  I2C_1, STM_PIN_DATA(STM_MODE_AF_OD, GPIO_NOPULL, GPIO_AF1_I2C1)},
    {PB_11, I2C_2, STM_PIN_DATA(STM_MODE_AF_OD, GPIO_NOPULL, GPIO_AF1_I2C2)},
    {PB_14, I2C_2, STM_PIN_DATA(STM_MODE_AF_OD, GPIO_NOPULL, GPIO_AF5_I2C2)},
//  {PF_0,  I2C_1, STM_PIN_DATA(STM_MODE_AF_OD, GPIO_NOPULL, GPIO_AF1_I2C1)}, // OSC_IN
    {NC,    NC,    0}
};

const PinMap PinMap_I2C_SCL[] = {
    {PA_9,  I2C_1, STM_PIN_DATA(STM_MODE_AF_OD, GPIO_NOPULL, GPIO_AF4_I2C1)},
    {PA_11, I2C_2, STM_PIN_DATA(STM_MODE_AF_OD, GPIO_NOPULL, GPIO_AF5_I2C2)},
    {PB_6,  I2C_1, STM_PIN_DATA(STM_MODE_AF_OD, GPIO_NOPULL, GPIO_AF1_I2C1)},
    {PB_8,  I2C_1, STM_PIN_DATA(STM_MODE_AF_OD, GPIO_NOPULL, GPIO_AF1_I2C1)},
    {PB_10, I2C_2, STM_PIN_DATA(STM_MODE_AF_OD, GPIO_NOPULL, GPIO_AF1_I2C2)},
    {PB_13, I2C_2, STM_PIN_DATA(STM_MODE_AF_OD, GPIO_NOPULL, GPIO_AF5_I2C2)},
//  {PF_1,  I2C_1, STM_PIN_DATA(STM_MODE_AF_OD, GPIO_NOPULL, GPIO_AF1_I2C1)}, // OSC_OUT
    {NC,    NC,    0}
};

//*** PWM ***

// TIM2 cannot be used because already used by the us_ticker
const PinMap PinMap_PWM[] = {
//  {PA_1,  PWM_2,  STM_PIN_DATA(STM_MODE_AF_PP, GPIO_PULLUP, GPIO_AF2_TIM2)},  // TIM2_CH2
    {PA_1,  PWM_15, STM_PIN_DATA(STM_MODE_AF_PP, GPIO_PULLUP, GPIO_AF5_TIM15)}, // TIM15_CH1N
    {PA_2,  PWM_15, STM_PIN_DATA(STM_MODE_AF_PP, GPIO_PULLUP, GPIO_AF0_TIM15)}, // TIM15_CH1
//  {PA_2,  PWM_2,  STM_PIN_DATA(STM_MODE_AF_PP, GPIO_PULLUP, GPIO_AF2_TIM2)},  // TIM2_CH3
    {PA_3,  PWM_15, STM_PIN_DATA(STM_MODE_AF_PP, GPIO_PULLUP, GPIO_AF0_TIM15)}, // TIM15_CH2
//  {PA_3,  PWM_2,  STM_PIN_DATA(STM_MODE_AF_PP, GPIO_PULLUP, GPIO_AF2_TIM2)},  // TIM2_CH4
    {PA_4,  PWM_14, STM_PIN_DATA(STM_MODE_AF_PP, GPIO_PULLUP, GPIO_AF4_TIM14)}, // TIM14_CH1
//  {PA_6,  PWM_3,  STM_PIN_DATA(STM_MODE_AF_PP, GPIO_PULLUP, GPIO_AF1_TIM3)},  // TIM3_CH1
    {PA_6,  PWM_16, STM_PIN_DATA(STM_MODE_AF_PP, GPIO_PULLUP, GPIO_AF5_TIM16)}, // TIM16_CH1
//  {PA_7,  PWM_3,  STM_PIN_DATA(STM_MODE_AF_PP, GPIO_PULLUP, GPIO_AF1_TIM3)},  // TIM3_CH2
//  {PA_7,  PWM_1,  STM_PIN_DATA(STM_MODE_AF_PP, GPIO_PULLUP, GPIO_AF2_TIM1)},  // TIM1_CH1N
//  {PA_7,  PWM_14, STM_PIN_DATA(STM_MODE_AF_PP, GPIO_PULLUP, GPIO_AF4_TIM14)}, // TIM14_CH1
    {PA_7,  PWM_17, STM_PIN_DATA(STM_MODE_AF_PP, GPIO_PULLUP, GPIO_AF5_TIM17)}, // TIM17_CH1
    {PA_8,  PWM_1,  STM_PIN_DATA(STM_MODE_AF_PP, GPIO_PULLUP, GPIO_AF2_TIM1)},  // TIM1_CH1
    {PA_9,  PWM_1,  STM_PIN_DATA(STM_MODE_AF_PP, GPIO_PULLUP, GPIO_AF2_TIM1)},  // TIM1_CH2
    {PA_10, PWM_1,  STM_PIN_DATA(STM_MODE_AF_PP, GPIO_PULLUP, GPIO_AF2_TIM1)},  // TIM1_CH3
    {PA_11, PWM_1,  STM_PIN_DATA(STM_MODE_AF_PP, GPIO_PULLUP, GPIO_AF2_TIM1)},  // TIM1_CH4

    {PB_0,  PWM_3,  STM_PIN_DATA(STM_MODE_AF_PP, GPIO_PULLUP, GPIO_AF1_TIM3)},  // TIM3_CH3
//  {PB_0,  PWM_1,  STM_PIN_DATA(STM_MODE_AF_PP, GPIO_PULLUP, GPIO_AF2_TIM1)},  // TIM1_CH2N
    {PB_1,  PWM_14, STM_PIN_DATA(STM_MODE_AF_PP, GPIO_PULLUP, GPIO_AF0_TIM14)}, // TIM14_CH1
//  {PB_1,  PWM_3,  STM_PIN_DATA(STM_MODE_AF_PP, GPIO_PULLUP, GPIO_AF1_TIM3)},  // TIM3_CH4
//  {PB_1,  PWM_1,  STM_PIN_DATA(STM_MODE_AF_PP, GPIO_PULLUP, GPIO_AF2_TIM1)},  // TIM1_CH3N
//  {PB_3,  PWM_2,  STM_PIN_DATA(STM_MODE_AF_PP, GPIO_PULLUP, GPIO_AF2_TIM2)},  // TIM2_CH2
    {PB_4,  PWM_3,  STM_PIN_DATA(STM_MODE_AF_PP, GPIO_PULLUP, GPIO_AF1_TIM3)},  // TIM3_CH1
    {PB_5,  PWM_3,  STM_PIN_DATA(STM_MODE_AF_PP, GPIO_PULLUP, GPIO_AF1_TIM3)},  // TIM3_CH2
    {PB_6,  PWM_16, STM_PIN_DATA(STM_MODE_AF_PP, GPIO_PULLUP, GPIO_AF2_TIM16)}, // TIM16_CH1N
    {PB_7,  PWM_17, STM_PIN_DATA(STM_MODE_AF_PP, GPIO_PULLUP, GPIO_AF2_TIM17)}, // TIM17_CH1N
    {PB_8,  PWM_16, STM_PIN_DATA(STM_MODE_AF_PP, GPIO_PULLUP, GPIO_AF2_TIM16)}, // TIM16_CH1
    {PB_9,  PWM_17, STM_PIN_DATA(STM_MODE_AF_PP, GPIO_PULLUP, GPIO_AF2_TIM17)}, // TIM17_CH1
//  {PB_10, PWM_2,  STM_PIN_DATA(STM_MODE_AF_PP, GPIO_PULLUP, GPIO_AF2_TIM2)},  // TIM2_CH3
//  {PB_11, PWM_2,  STM_PIN_DATA(STM_MODE_AF_PP, GPIO_PULLUP, GPIO_AF2_TIM2)},  // TIM2_CH4
    {PB_13, PWM_1,  STM_PIN_DATA(STM_MODE_AF_PP, GPIO_PULLUP, GPIO_AF2_TIM1)},  // TIM1_CH1N
    {PB_14, PWM_15, STM_PIN_DATA(STM_MODE_AF_PP, GPIO_PULLUP, GPIO_AF1_TIM15)}, // TIM15_CH1
//  {PB_14, PWM_1,  STM_PIN_DATA(STM_MODE_AF_PP, GPIO_PULLUP, GPIO_AF2_TIM1)},  // TIM1_CH2N
    {PB_15, PWM_15, STM_PIN_DATA(STM_MODE_AF_PP, GPIO_PULLUP, GPIO_AF1_TIM15)}, // TIM15_CH2
//  {PB_15, PWM_1,  STM_PIN_DATA(STM_MODE_AF_PP, GPIO_PULLUP, GPIO_AF2_TIM1)},  // TIM1_CH3N
//  {PB_15, PWM_15, STM_PIN_DATA(STM_MODE_AF_PP, GPIO_PULLUP, GPIO_AF3_TIM15)}, // TIM15_CH1N

    {PC_6,  PWM_3,  STM_PIN_DATA(STM_MODE_AF_PP, GPIO_PULLUP, GPIO_AF0_TIM3)},  // TIM3_CH1
    {PC_7,  PWM_3,  STM_PIN_DATA(STM_MODE_AF_PP, GPIO_PULLUP, GPIO_AF0_TIM3)},  // TIM3_CH2
    {PC_8,  PWM_3,  STM_PIN_DATA(STM_MODE_AF_PP, GPIO_PULLUP, GPIO_AF0_TIM3)},  // TIM3_CH3
    {PC_9,  PWM_3,  STM_PIN_DATA(STM_MODE_AF_PP, GPIO_PULLUP, GPIO_AF0_TIM3)},  // TIM3_CH4

    {NC,    NC,    0}
};

//*** SERIAL ***

const PinMap PinMap_UART_TX[] = {
    {PA_0,  UART_4, STM_PIN_DATA(STM_MODE_AF_PP, GPIO_PULLUP, GPIO_AF4_USART4)},
    {PA_2,  UART_2, STM_PIN_DATA(STM_MODE_AF_PP, GPIO_PULLUP, GPIO_AF1_USART2)},
    {PA_4,  UART_6, STM_PIN_DATA(STM_MODE_AF_PP, GPIO_PULLUP, GPIO_AF5_USART6)},
    {PA_9,  UART_1, STM_PIN_DATA(STM_MODE_AF_PP, GPIO_PULLUP, GPIO_AF1_USART1)},
    {PA_14, UART_2, STM_PIN_DATA(STM_MODE_AF_PP, GPIO_PULLUP, GPIO_AF1_USART2)}, // Warning: SWCLK is also on this pin
    {PB_3,  UART_5, STM_PIN_DATA(STM_MODE_AF_PP, GPIO_PULLUP, GPIO_AF4_USART5)},
    {PB_6,  UART_1, STM_PIN_DATA(STM_MODE_AF_PP, GPIO_PULLUP, GPIO_AF0_USART1)},
    {PB_10, UART_3, STM_PIN_DATA(STM_MODE_AF_PP, GPIO_PULLUP, GPIO_AF4_USART3)},
//  {PC_0,  UART_7, STM_PIN_DATA(STM_MODE_AF_PP, GPIO_PULLUP, GPIO_AF1_USART7)},
    {PC_0,  UART_6, STM_PIN_DATA(STM_MODE_AF_PP, GPIO_PULLUP, GPIO_AF2_USART6)},
    {PC_2,  UART_8, STM_PIN_DATA(STM_MODE_AF_PP, GPIO_PULLUP, GPIO_AF2_USART8)},
    {PC_4,  UART_3, STM_PIN_DATA(STM_MODE_AF_PP, GPIO_PULLUP, GPIO_AF1_USART3)},
    {PC_6,  UART_7, STM_PIN_DATA(STM_MODE_AF_PP, GPIO_PULLUP, GPIO_AF1_USART7)},
    {PC_8,  UART_8, STM_PIN_DATA(STM_MODE_AF_PP, GPIO_PULLUP, GPIO_AF1_USART8)},
    {PC_10, UART_4, STM_PIN_DATA(STM_MODE_AF_PP, GPIO_PULLUP, GPIO_AF0_USART4)},
//  {PC_10, UART_3, STM_PIN_DATA(STM_MODE_AF_PP, GPIO_PULLUP, GPIO_AF1_USART3)},
    {PC_12, UART_5, STM_PIN_DATA(STM_MODE_AF_PP, GPIO_PULLUP, GPIO_AF2_USART5)},
    {NC,    NC,     0}
};

const PinMap PinMap_UART_RX[] = {
    {PA_1,  UART_4, STM_PIN_DATA(STM_MODE_AF_PP, GPIO_PULLUP, GPIO_AF4_USART4)},
    {PA_3,  UART_2, STM_PIN_DATA(STM_MODE_AF_PP, GPIO_PULLUP, GPIO_AF1_USART2)},
    {PA_5,  UART_6, STM_PIN_DATA(STM_MODE_AF_PP, GPIO_PULLUP, GPIO_AF5_USART6)},
    {PA_10, UART_1, STM_PIN_DATA(STM_MODE_AF_PP, GPIO_PULLUP, GPIO_AF1_USART1)},
    {PA_15, UART_2, STM_PIN_DATA(STM_MODE_AF_PP, GPIO_PULLUP, GPIO_AF1_USART2)},
    {PB_4,  UART_5, STM_PIN_DATA(STM_MODE_AF_PP, GPIO_PULLUP, GPIO_AF4_USART5)},
    {PB_7,  UART_1, STM_PIN_DATA(STM_MODE_AF_PP, GPIO_PULLUP, GPIO_AF0_USART1)},
    {PB_11, UART_3, STM_PIN_DATA(STM_MODE_AF_PP, GPIO_PULLUP, GPIO_AF4_USART3)},
//  {PC_1,  UART_7, STM_PIN_DATA(STM_MODE_AF_PP, GPIO_PULLUP, GPIO_AF1_USART7)},
    {PC_1,  UART_6, STM_PIN_DATA(STM_MODE_AF_PP, GPIO_PULLUP, GPIO_AF2_USART6)},
    {PC_3,  UART_8, STM_PIN_DATA(STM_MODE_AF_PP, GPIO_PULLUP, GPIO_AF2_USART8)},
    {PC_5,  UART_3, STM_PIN_DATA(STM_MODE_AF_PP, GPIO_PULLUP, GPIO_AF1_USART3)},
    {PC_7,  UART_7, STM_PIN_DATA(STM_MODE_AF_PP, GPIO_PULLUP, GPIO_AF1_USART7)},
    {PC_9,  UART_8, STM_PIN_DATA(STM_MODE_AF_PP, GPIO_PULLUP, GPIO_AF1_USART8)},
    {PC_11, UART_4, STM_PIN_DATA(STM_MODE_AF_PP, GPIO_PULLUP, GPIO_AF0_USART4)},
//  {PC_11, UART_3, STM_PIN_DATA(STM_MODE_AF_PP, GPIO_PULLUP, GPIO_AF1_USART3)},
    {PD_2,  UART_5, STM_PIN_DATA(STM_MODE_AF_PP, GPIO_PULLUP, GPIO_AF2_USART5)},
    {NC,    NC,     0}
};

//*** SPI ***

const PinMap PinMap_SPI_MOSI[] = {
    {PA_7,  SPI_1, STM_PIN_DATA(STM_MODE_AF_PP, GPIO_PULLUP, GPIO_AF0_SPI1)},
    {PB_5,  SPI_1, STM_PIN_DATA(STM_MODE_AF_PP, GPIO_PULLUP, GPIO_AF0_SPI1)},
    {PB_15, SPI_2, STM_PIN_DATA(STM_MODE_AF_PP, GPIO_PULLUP, GPIO_AF0_SPI2)},
    {PC_3,  SPI_2, STM_PIN_DATA(STM_MODE_AF_PP, GPIO_PULLUP, GPIO_AF1_SPI2)},
    {NC,    NC,    0}
};

const PinMap PinMap_SPI_MISO[] = {
    {PA_6,  SPI_1, STM_PIN_DATA(STM_MODE_AF_PP, GPIO_PULLUP, GPIO_AF0_SPI1)},
    {PB_4,  SPI_1, STM_PIN_DATA(STM_MODE_AF_PP, GPIO_PULLUP, GPIO_AF0_SPI1)},
    {PB_14, SPI_2, STM_PIN_DATA(STM_MODE_AF_PP, GPIO_PULLUP, GPIO_AF0_SPI2)},
    {PC_2,  SPI_2, STM_PIN_DATA(STM_MODE_AF_PP, GPIO_PULLUP, GPIO_AF1_SPI2)},
    {NC,    NC,    0}
};

const PinMap PinMap_SPI_SCLK[] = {
    {PA_5,  SPI_1, STM_PIN_DATA(STM_MODE_AF_PP, GPIO_PULLUP, GPIO_AF0_SPI1)},
    {PB_3,  SPI_1, STM_PIN_DATA(STM_MODE_AF_PP, GPIO_PULLUP, GPIO_AF0_SPI1)},
    {PB_10, SPI_2, STM_PIN_DATA(STM_MODE_AF_PP, GPIO_PULLUP, GPIO_AF5_SPI2)},
    {PB_13, SPI_2, STM_PIN_DATA(STM_MODE_AF_PP, GPIO_PULLUP, GPIO_AF0_SPI2)},
    {NC,    NC,    0}
};

const PinMap PinMap_SPI_SSEL[] = {
    {PA_4,  SPI_1, STM_PIN_DATA(STM_MODE_AF_PP, GPIO_PULLUP, GPIO_AF0_SPI1)},
    {PA_15, SPI_1, STM_PIN_DATA(STM_MODE_AF_PP, GPIO_PULLUP, GPIO_AF0_SPI1)},
    {PB_9,  SPI_2, STM_PIN_DATA(STM_MODE_AF_PP, GPIO_PULLUP, GPIO_AF5_SPI2)},
    {PB_12, SPI_2, STM_PIN_DATA(STM_MODE_AF_PP, GPIO_PULLUP, GPIO_AF0_SPI2)},
    {NC,    NC,    0}
};
