nickmolo/ECE477/Software/display/mbed-src/targets/hal/TARGET_STM/TARGET_STM32F3/TARGET_DISCO_F303VC/PeripheralPins.c

/* mbed Microcontroller Library
 *******************************************************************************
 * Copyright (c) 2015, STMicroelectronics
 * All rights reserved.
 *
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
 * THIS SOFTWARE IS PROVIDED BY THE COPYRIGHT HOLDERS AND CONTRIBUTORS "AS IS"
 * AND ANY EXPRESS OR IMPLIED WARRANTIES, INCLUDING, BUT NOT LIMITED TO, THE
 * IMPLIED WARRANTIES OF MERCHANTABILITY AND FITNESS FOR A PARTICULAR PURPOSE ARE
 * DISCLAIMED. IN NO EVENT SHALL THE COPYRIGHT HOLDER OR CONTRIBUTORS BE LIABLE
 * FOR ANY DIRECT, INDIRECT, INCIDENTAL, SPECIAL, EXEMPLARY, OR CONSEQUENTIAL
 * DAMAGES (INCLUDING, BUT NOT LIMITED TO, PROCUREMENT OF SUBSTITUTE GOODS OR
 * SERVICES; LOSS OF USE, DATA, OR PROFITS; OR BUSINESS INTERRUPTION) HOWEVER
 * CAUSED AND ON ANY THEORY OF LIABILITY, WHETHER IN CONTRACT, STRICT LIABILITY,
 * OR TORT (INCLUDING NEGLIGENCE OR OTHERWISE) ARISING IN ANY WAY OUT OF THE USE
 * OF THIS SOFTWARE, EVEN IF ADVISED OF THE POSSIBILITY OF SUCH DAMAGE.
 *******************************************************************************
 */

#include "PeripheralPins.h"

// =====
// Note: Commented lines are alternative possibilities which are not used per default.
//       If you change them, you will have also to modify the corresponding xxx_api.c file
//       for pwmout, analogin, analogout, ...
// =====

//*** ADC ***

const PinMap PinMap_ADC[] = {
    {PA_0,  ADC_1, STM_PIN_DATA_EXT(STM_MODE_ANALOG, GPIO_NOPULL, 0, 1, 0)}, // ADC1_IN1
    {PA_1,  ADC_1, STM_PIN_DATA_EXT(STM_MODE_ANALOG, GPIO_NOPULL, 0, 2, 0)}, // ADC1_IN2
    {PA_2,  ADC_1, STM_PIN_DATA_EXT(STM_MODE_ANALOG, GPIO_NOPULL, 0, 3, 0)}, // ADC1_IN3
    {PA_3,  ADC_1, STM_PIN_DATA_EXT(STM_MODE_ANALOG, GPIO_NOPULL, 0, 4, 0)}, // ADC1_IN4
    {PA_4,  ADC_2, STM_PIN_DATA_EXT(STM_MODE_ANALOG, GPIO_NOPULL, 0, 1, 0)}, // ADC2_IN1
    {PA_5,  ADC_2, STM_PIN_DATA_EXT(STM_MODE_ANALOG, GPIO_NOPULL, 0, 5, 0)}, // ADC2_IN5
    {PA_6,  ADC_2, STM_PIN_DATA_EXT(STM_MODE_ANALOG, GPIO_NOPULL, 0, 3, 0)}, // ADC2_IN3
    {PA_7,  ADC_2, STM_PIN_DATA_EXT(STM_MODE_ANALOG, GPIO_NOPULL, 0, 4, 0)}, // ADC2_IN4

    {PB_0,  ADC_3, STM_PIN_DATA_EXT(STM_MODE_ANALOG, GPIO_NOPULL, 0, 12, 0)}, // ADC3_IN12
    {PB_1,  ADC_3, STM_PIN_DATA_EXT(STM_MODE_ANALOG, GPIO_NOPULL, 0, 1, 0)}, // ADC1_IN1
    {PB_2,  ADC_2, STM_PIN_DATA_EXT(STM_MODE_ANALOG, GPIO_NOPULL, 0, 12, 0)}, // ADC2_IN12
    {PB_11, ADC_1, STM_PIN_DATA_EXT(STM_MODE_ANALOG, GPIO_NOPULL, 0, 14, 0)}, // ADC1_IN14
    {PB_13, ADC_3, STM_PIN_DATA_EXT(STM_MODE_ANALOG, GPIO_NOPULL, 0, 5, 0)}, // ADC3_IN5

    {PC_0,  ADC_1, STM_PIN_DATA_EXT(STM_MODE_ANALOG, GPIO_NOPULL, 0, 6, 0)}, // ADC1_IN6
    {PC_1,  ADC_1, STM_PIN_DATA_EXT(STM_MODE_ANALOG, GPIO_NOPULL, 0, 7, 0)}, // ADC1_IN7
    {PC_2,  ADC_1, STM_PIN_DATA_EXT(STM_MODE_ANALOG, GPIO_NOPULL, 0, 8, 0)}, // ADC1_IN8
    {PC_3,  ADC_1, STM_PIN_DATA_EXT(STM_MODE_ANALOG, GPIO_NOPULL, 0, 9, 0)}, // ADC1_IN9
    {PC_4,  ADC_2, STM_PIN_DATA_EXT(STM_MODE_ANALOG, GPIO_NOPULL, 0, 5, 0)}, // ADC2_IN5
    {PC_5,  ADC_2, STM_PIN_DATA_EXT(STM_MODE_ANALOG, GPIO_NOPULL, 0, 11, 0)}, // ADC2_IN11

    {PF_2,  ADC_1, STM_PIN_DATA_EXT(STM_MODE_ANALOG, GPIO_NOPULL, 0, 10, 0)}, // ADC1_IN10
    {PF_4,  ADC_1, STM_PIN_DATA_EXT(STM_MODE_ANALOG, GPIO_NOPULL, 0, 5, 0)}, // ADC1_IN5
    {NC,   NC,    0}
};

//*** DAC ***

const PinMap PinMap_DAC[] = {
    {PA_4, DAC_1, STM_PIN_DATA_EXT(STM_MODE_ANALOG, GPIO_NOPULL, 0, 1, 0)}, // DAC1_OUT1
    {PA_5, DAC_1, STM_PIN_DATA_EXT(STM_MODE_ANALOG, GPIO_NOPULL, 0, 2, 0)}, // DAC1_OUT2
    {NC,   NC,    0}
};

//*** I2C ***

const PinMap PinMap_I2C_SDA[] = {
    {PA_10, I2C_2, STM_PIN_DATA(STM_MODE_AF_OD, GPIO_NOPULL, GPIO_AF4_I2C2)},
    {PA_14, I2C_1, STM_PIN_DATA(STM_MODE_AF_OD, GPIO_NOPULL, GPIO_AF4_I2C1)},
    {PB_7,  I2C_1, STM_PIN_DATA(STM_MODE_AF_OD, GPIO_NOPULL, GPIO_AF4_I2C1)},
    {PB_9,  I2C_1, STM_PIN_DATA(STM_MODE_AF_OD, GPIO_NOPULL, GPIO_AF4_I2C1)},
    {PF_0,  I2C_2, STM_PIN_DATA(STM_MODE_AF_OD, GPIO_NOPULL, GPIO_AF4_I2C2)},
    {NC,    NC,    0}
};

const PinMap PinMap_I2C_SCL[] = {
    {PA_9,  I2C_2, STM_PIN_DATA(STM_MODE_AF_OD, GPIO_NOPULL, GPIO_AF4_I2C2)},
    {PA_15, I2C_1, STM_PIN_DATA(STM_MODE_AF_OD, GPIO_NOPULL, GPIO_AF4_I2C1)},
    {PB_6,  I2C_1, STM_PIN_DATA(STM_MODE_AF_OD, GPIO_NOPULL, GPIO_AF4_I2C1)},
    {PB_8,  I2C_1, STM_PIN_DATA(STM_MODE_AF_OD, GPIO_NOPULL, GPIO_AF4_I2C1)},
    {PF_1,  I2C_2, STM_PIN_DATA(STM_MODE_AF_OD, GPIO_NOPULL, GPIO_AF4_I2C2)},
    {PF_6,  I2C_2, STM_PIN_DATA(STM_MODE_AF_OD, GPIO_NOPULL, GPIO_AF4_I2C2)},
    {NC,    NC,    0}
};

//*** PWM ***

// TIM2 cannot be used because already used by the us_ticker
const PinMap PinMap_PWM[] = {
    /*
     * The lines below show all combinations to conect a port pin with a timer. Commented
     * lines are alternative possibilities not used per default. But they can be changed
     * manually instead of the suggested configuration. For example you can see that on
     * PA_5 you can have a PWM using either Timer2/Channel1 or Timer8/Channel1N. Today I
     * have decided to use Timer2/Channel1. But you can also notice that Timer2/Channel1
     * is also used on PA_0. That means that today you cannot output two different PWM
     * signals on PA_0 and PA_5 at the same time. If someone wants this, he will need to
     * change the timer that is used on PA_5. This is why the other possibilities are
     * commented to make this change easier without looking deeply into the mcu datasheet.
     */
    {PA_1,  PWM_15, STM_PIN_DATA_EXT(STM_MODE_AF_PP, GPIO_PULLUP, GPIO_AF9_TIM15, 1, 1)}, // TIM15_CH1N
    {PA_2,  PWM_15, STM_PIN_DATA_EXT(STM_MODE_AF_PP, GPIO_PULLUP, GPIO_AF9_TIM15, 1, 0)}, // TIM15_CH1
    {PA_3,  PWM_15, STM_PIN_DATA_EXT(STM_MODE_AF_PP, GPIO_PULLUP, GPIO_AF9_TIM15, 2, 0)}, // TIM15_CH2
    {PA_4,  PWM_3,  STM_PIN_DATA_EXT(STM_MODE_AF_PP, GPIO_PULLUP, GPIO_AF2_TIM3, 2, 0)},  // TIM3_CH2
    {PA_6,  PWM_16, STM_PIN_DATA_EXT(STM_MODE_AF_PP, GPIO_PULLUP, GPIO_AF1_TIM16, 1, 0)}, // TIM16_CH1
    //{PA_6,  PWM_3, STM_PIN_DATA_EXT(STM_MODE_AF_PP, GPIO_PULLUP, GPIO_AF2_TIM3, 2, 0)}, // TIM3_CH2
    {PA_7,  PWM_17, STM_PIN_DATA_EXT(STM_MODE_AF_PP, GPIO_PULLUP, GPIO_AF1_TIM17, 1, 0)}, // TIM17_CH1
//  {PA_7,  PWM_3,  STM_PIN_DATA_EXT(STM_MODE_AF_PP, GPIO_PULLUP, GPIO_AF2_TIM3, 2, 0)},  // TIM3_CH2
//  {PA_7,  PWM_1,  STM_PIN_DATA_EXT(STM_MODE_AF_PP, GPIO_PULLUP, GPIO_AF6_TIM1, 1, 1)},  // TIM1_CH1N
    {PA_8,  PWM_1,  STM_PIN_DATA_EXT(STM_MODE_AF_PP, GPIO_PULLUP, GPIO_AF6_TIM1, 1, 0)},  // TIM1_CH1
    {PA_9,  PWM_1,  STM_PIN_DATA_EXT(STM_MODE_AF_PP, GPIO_PULLUP, GPIO_AF6_TIM1, 2, 0)},  // TIM1_CH2
//  {PA_9,  PWM_2,  STM_PIN_DATA_EXT(STM_MODE_AF_PP, GPIO_PULLUP, GPIO_AF10_TIM2, 3, 0)}, // TIM2_CH3
    {PA_10, PWM_1,  STM_PIN_DATA_EXT(STM_MODE_AF_PP, GPIO_PULLUP, GPIO_AF6_TIM1, 3, 0)},  // TIM1_CH3
    {PA_11, PWM_1,  STM_PIN_DATA_EXT(STM_MODE_AF_PP, GPIO_PULLUP, GPIO_AF11_TIM1, 4, 0)}, // TIM1_CH4
//  {PA_11, PWM_4,  STM_PIN_DATA_EXT(STM_MODE_AF_PP, GPIO_PULLUP, GPIO_AF10_TIM4, 1, 0)}, // TIM4_CH1
//  {PA_11, PWM_1,  STM_PIN_DATA_EXT(STM_MODE_AF_PP, GPIO_PULLUP, GPIO_AF6_TIM1, 1, 1)},  // TIM1_CH1N
    {PA_12, PWM_16, STM_PIN_DATA_EXT(STM_MODE_AF_PP, GPIO_PULLUP, GPIO_AF1_TIM16, 1, 0)}, // TIM16_CH1
//  {PA_12, PWM_1,  STM_PIN_DATA_EXT(STM_MODE_AF_PP, GPIO_PULLUP, GPIO_AF6_TIM1, 2, 1)},  // TIM1_CH2N
//  {PA_12, PWM_4,  STM_PIN_DATA_EXT(STM_MODE_AF_PP, GPIO_PULLUP, GPIO_AF10_TIM4, 2, 0)}, // TIM4_CH2
    {PA_13, PWM_16, STM_PIN_DATA_EXT(STM_MODE_AF_PP, GPIO_PULLUP, GPIO_AF1_TIM16, 1, 1)}, // TIM16_CH1N
//  {PA_13, PWM_1,  STM_PIN_DATA_EXT(STM_MODE_AF_PP, GPIO_PULLUP, GPIO_AF6_TIM1, 2, 1)}, // TIM1_CH2N
    {PA_14, PWM_8,  STM_PIN_DATA_EXT(STM_MODE_AF_PP, GPIO_PULLUP, GPIO_AF5_TIM8, 2, 0)},  // TIM8_CH2

    {PB_0,  PWM_1,  STM_PIN_DATA_EXT(STM_MODE_AF_PP, GPIO_PULLUP, GPIO_AF6_TIM1, 2, 1)},  // TIM1_CH2N
    //{PB_0,  PWM_8,  STM_PIN_DATA_EXT(STM_MODE_AF_PP, GPIO_PULLUP, GPIO_AF4_TIM8, 2, 1)},  // TIM8_CH2N
    //{PB_0,  PWM_3,  STM_PIN_DATA_EXT(STM_MODE_AF_PP, GPIO_PULLUP, GPIO_AF2_TIM3, 3, 0)},  // TIM3_CH3
    {PB_1,  PWM_1,  STM_PIN_DATA_EXT(STM_MODE_AF_PP, GPIO_PULLUP, GPIO_AF6_TIM1, 3, 1)},  // TIM1_CH3N
    //{PB_1,  PWM_8,  STM_PIN_DATA_EXT(STM_MODE_AF_PP, GPIO_PULLUP, GPIO_AF4_TIM8, 3, 1)},  // TIM8_CH3N
    //{PB_1,  PWM_3,  STM_PIN_DATA_EXT(STM_MODE_AF_PP, GPIO_PULLUP, GPIO_AF2_TIM3, 4, 0)},  // TIM3_CH4
    {PB_3,  PWM_8,  STM_PIN_DATA_EXT(STM_MODE_AF_PP, GPIO_PULLUP, GPIO_AF4_TIM8, 1, 1)},  // TIM8_CH1N
    {PB_4,  PWM_16, STM_PIN_DATA_EXT(STM_MODE_AF_PP, GPIO_PULLUP, GPIO_AF1_TIM16, 1, 0)}, // TIM16_CH1
    //{PB_4,  PWM_8, STM_PIN_DATA_EXT(STM_MODE_AF_PP, GPIO_PULLUP, GPIO_AF1_TIM8, 2, 1)}, // TIM8_CH2N
    //{PB_4,  PWM_3, STM_PIN_DATA_EXT(STM_MODE_AF_PP, GPIO_PULLUP, GPIO_AF2_TIM3, 1, 0)}, // TIM3_CH1
    {PB_5,  PWM_17, STM_PIN_DATA_EXT(STM_MODE_AF_PP, GPIO_PULLUP, GPIO_AF10_TIM17, 1, 0)}, // TIM17_CH1
    //{PB_5,  PWM_8, STM_PIN_DATA_EXT(STM_MODE_AF_PP, GPIO_PULLUP, GPIO_AF3_TIM8, 3, 1)}, // TIM8_CH3N
    //{PB_5,  PWM_3, STM_PIN_DATA_EXT(STM_MODE_AF_PP, GPIO_PULLUP, GPIO_AF2_TIM3, 2, 0)}, // TIM3_CH2
    {PB_6,  PWM_16, STM_PIN_DATA_EXT(STM_MODE_AF_PP, GPIO_PULLUP, GPIO_AF1_TIM16, 1, 1)}, // TIM16_CH1N
    //{PB_6,  PWM_4, STM_PIN_DATA_EXT(STM_MODE_AF_PP, GPIO_PULLUP, GPIO_AF2_TIM4, 1, 0)}, // TIM4_CH1
    //{PB_6,  PWM_8, STM_PIN_DATA_EXT(STM_MODE_AF_PP, GPIO_PULLUP, GPIO_AF5_TIM8, 1, 0)}, // TIM8_CH1
    {PB_7,  PWM_17, STM_PIN_DATA_EXT(STM_MODE_AF_PP, GPIO_PULLUP, GPIO_AF1_TIM17, 1, 1)}, // TIM17_CH1N
    //{PB_7,  PWM_4, STM_PIN_DATA_EXT(STM_MODE_AF_PP, GPIO_PULLUP, GPIO_AF2_TIM4, 2, 0)}, // TIM4_CH2
    //{PB_7,  PWM_3, STM_PIN_DATA_EXT(STM_MODE_AF_PP, GPIO_PULLUP, GPIO_AF10_TIM3, 4, 0)}, // TIM3_CH4
    {PB_8,  PWM_16, STM_PIN_DATA_EXT(STM_MODE_AF_PP, GPIO_PULLUP, GPIO_AF1_TIM16, 1, 0)}, // TIM16_CH1
    //{PB_8,  PWM_4, STM_PIN_DATA_EXT(STM_MODE_AF_PP, GPIO_PULLUP, GPIO_AF2_TIM4, 3, 0)}, // TIM4_CH3
    //{PB_8,  PWM_8, STM_PIN_DATA_EXT(STM_MODE_AF_PP, GPIO_PULLUP, GPIO_AF10_TIM8, 2, 0)}, // TIM8_CH2
    {PB_9,  PWM_17, STM_PIN_DATA_EXT(STM_MODE_AF_PP, GPIO_PULLUP, GPIO_AF1_TIM17, 1, 0)}, // TIM17_CH1
    //{PB_9,  PWM_4, STM_PIN_DATA_EXT(STM_MODE_AF_PP, GPIO_PULLUP, GPIO_AF2_TIM4, 4, 0)}, // TIM4_CH4
    //{PB_9,  PWM_8, STM_PIN_DATA_EXT(STM_MODE_AF_PP, GPIO_PULLUP, GPIO_AF10_TIM8, 3, 0)}, // TIM8_CH3
    {PB_13, PWM_1,  STM_PIN_DATA_EXT(STM_MODE_AF_PP, GPIO_PULLUP, GPIO_AF6_TIM1, 1, 1)},  // TIM1_CH1N
    {PB_14, PWM_15, STM_PIN_DATA_EXT(STM_MODE_AF_PP, GPIO_PULLUP, GPIO_AF1_TIM15, 1, 0)}, // TIM15_CH1
//  {PB_14, PWM_1,  STM_PIN_DATA_EXT(STM_MODE_AF_PP, GPIO_PULLUP, GPIO_AF6_TIM1, 2, 1)},  // TIM1_CH2N
    {PB_15, PWM_15, STM_PIN_DATA_EXT(STM_MODE_AF_PP, GPIO_PULLUP, GPIO_AF1_TIM15, 2, 0)}, // TIM15_CH2
//  {PB_15, PWM_15, STM_PIN_DATA_EXT(STM_MODE_AF_PP, GPIO_PULLUP, GPIO_AF2_TIM15, 1, 1)}, // TIM15_CH1N
//  {PB_15, PWM_1,  STM_PIN_DATA_EXT(STM_MODE_AF_PP, GPIO_PULLUP, GPIO_AF4_TIM1, 3, 1)},  // TIM1_CH3N

    //{PC_6,  PWM_3,  STM_PIN_DATA_EXT(STM_MODE_AF_PP, GPIO_PULLUP, GPIO_AF2_TIM3, 1, 0)},  // TIM3_CH1
    {PC_6,  PWM_8,  STM_PIN_DATA_EXT(STM_MODE_AF_PP, GPIO_PULLUP, GPIO_AF4_TIM8, 1, 0)},  // TIM8_CH1
    //{PC_7,  PWM_3,  STM_PIN_DATA_EXT(STM_MODE_AF_PP, GPIO_PULLUP, GPIO_AF2_TIM3, 2, 0)},  // TIM3_CH2
    {PC_7,  PWM_8,  STM_PIN_DATA_EXT(STM_MODE_AF_PP, GPIO_PULLUP, GPIO_AF4_TIM8, 2, 0)},  // TIM8_CH2
    //{PC_8,  PWM_3,  STM_PIN_DATA_EXT(STM_MODE_AF_PP, GPIO_PULLUP, GPIO_AF2_TIM3, 3, 0)},  // TIM3_CH3
    {PC_8,  PWM_8,  STM_PIN_DATA_EXT(STM_MODE_AF_PP, GPIO_PULLUP, GPIO_AF4_TIM8, 3, 0)},  // TIM8_CH3
    //{PC_9,  PWM_3,  STM_PIN_DATA_EXT(STM_MODE_AF_PP, GPIO_PULLUP, GPIO_AF2_TIM3, 4, 0)},  // TIM3_CH4
    {PC_9,  PWM_8,  STM_PIN_DATA_EXT(STM_MODE_AF_PP, GPIO_PULLUP, GPIO_AF4_TIM8, 4, 0)},  // TIM8_CH4
    {PC_10, PWM_8,  STM_PIN_DATA_EXT(STM_MODE_AF_PP, GPIO_PULLUP, GPIO_AF4_TIM8, 1, 1)},  // TIM8_CH1N
    {PC_11, PWM_8,  STM_PIN_DATA_EXT(STM_MODE_AF_PP, GPIO_PULLUP, GPIO_AF4_TIM8, 2, 1)},  // TIM8_CH2N
    {PC_12, PWM_8,  STM_PIN_DATA_EXT(STM_MODE_AF_PP, GPIO_PULLUP, GPIO_AF4_TIM8, 3, 1)},  // TIM8_CH3N
    {PC_13, PWM_8,  STM_PIN_DATA_EXT(STM_MODE_AF_PP, GPIO_PULLUP, GPIO_AF4_TIM8, 4, 1)},  // TIM8_CH4N

    {PD_1,  PWM_8,  STM_PIN_DATA_EXT(STM_MODE_AF_PP, GPIO_PULLUP, GPIO_AF4_TIM8, 4, 0)},  // TIM8_CH4
    {PD_12, PWM_4,  STM_PIN_DATA_EXT(STM_MODE_AF_PP, GPIO_PULLUP, GPIO_AF2_TIM4, 1, 0)},  // TIM4_CH1
    {PD_13, PWM_4,  STM_PIN_DATA_EXT(STM_MODE_AF_PP, GPIO_PULLUP, GPIO_AF2_TIM4, 2, 0)},  // TIM4_CH2
    {PD_14, PWM_4,  STM_PIN_DATA_EXT(STM_MODE_AF_PP, GPIO_PULLUP, GPIO_AF2_TIM4, 3, 0)},  // TIM4_CH3
    {PD_15, PWM_4,  STM_PIN_DATA_EXT(STM_MODE_AF_PP, GPIO_PULLUP, GPIO_AF2_TIM4, 4, 0)},  // TIM4_CH4

    {PE_0,  PWM_16, STM_PIN_DATA_EXT(STM_MODE_AF_PP, GPIO_PULLUP, GPIO_AF4_TIM16, 1, 0)},  // TIM16_CH1
    {PE_1,  PWM_17, STM_PIN_DATA_EXT(STM_MODE_AF_PP, GPIO_PULLUP, GPIO_AF4_TIM17, 1, 0)},  // TIM17_CH1
    {PE_2,  PWM_3,  STM_PIN_DATA_EXT(STM_MODE_AF_PP, GPIO_PULLUP, GPIO_AF2_TIM3, 1, 0)},  // TIM3_CH1
    {PE_3,  PWM_3,  STM_PIN_DATA_EXT(STM_MODE_AF_PP, GPIO_PULLUP, GPIO_AF2_TIM3, 2, 0)},  // TIM3_CH2
    {PE_4,  PWM_3,  STM_PIN_DATA_EXT(STM_MODE_AF_PP, GPIO_PULLUP, GPIO_AF2_TIM3, 3, 0)},  // TIM3_CH3
    {PE_5,  PWM_3,  STM_PIN_DATA_EXT(STM_MODE_AF_PP, GPIO_PULLUP, GPIO_AF2_TIM3, 4, 0)},  // TIM3_CH4
    {PE_8,  PWM_1,  STM_PIN_DATA_EXT(STM_MODE_AF_PP, GPIO_PULLUP, GPIO_AF2_TIM1, 1, 1)},  // TIM1_CH1N
    {PE_9,  PWM_1,  STM_PIN_DATA_EXT(STM_MODE_AF_PP, GPIO_PULLUP, GPIO_AF2_TIM1, 1, 0)},  // TIM1_CH1
    {PE_10, PWM_1,  STM_PIN_DATA_EXT(STM_MODE_AF_PP, GPIO_PULLUP, GPIO_AF2_TIM1, 2, 1)},  // TIM1_CH2N
    {PE_11, PWM_1,  STM_PIN_DATA_EXT(STM_MODE_AF_PP, GPIO_PULLUP, GPIO_AF2_TIM1, 2, 0)},  // TIM1_CH2
    {PE_12, PWM_1,  STM_PIN_DATA_EXT(STM_MODE_AF_PP, GPIO_PULLUP, GPIO_AF2_TIM1, 3, 1)},  // TIM1_CH3N
    {PE_13, PWM_1,  STM_PIN_DATA_EXT(STM_MODE_AF_PP, GPIO_PULLUP, GPIO_AF2_TIM1, 3, 0)},  // TIM1_CH3
    {PE_14, PWM_1,  STM_PIN_DATA_EXT(STM_MODE_AF_PP, GPIO_PULLUP, GPIO_AF2_TIM1, 4, 0)},  // TIM1_CH4

    {PF_0,  PWM_1,  STM_PIN_DATA_EXT(STM_MODE_AF_PP, GPIO_PULLUP, GPIO_AF6_TIM1, 3, 1)},  // TIM1_CH3N
    {NC,    NC,     0}
};

//*** SERIAL ***

const PinMap PinMap_UART_TX[] = {
    {PA_2,  UART_2, STM_PIN_DATA(STM_MODE_AF_PP, GPIO_PULLUP, GPIO_AF7_USART2)},
    {PA_9,  UART_1, STM_PIN_DATA(STM_MODE_AF_PP, GPIO_PULLUP, GPIO_AF7_USART1)},
    {PA_14, UART_2, STM_PIN_DATA(STM_MODE_AF_PP, GPIO_PULLUP, GPIO_AF7_USART2)},
    {PB_3,  UART_2, STM_PIN_DATA(STM_MODE_AF_PP, GPIO_PULLUP, GPIO_AF7_USART2)},
    {PB_6,  UART_1, STM_PIN_DATA(STM_MODE_AF_PP, GPIO_PULLUP, GPIO_AF7_USART1)},
    {PB_10, UART_3, STM_PIN_DATA(STM_MODE_AF_PP, GPIO_PULLUP, GPIO_AF7_USART3)},
    {PC_10, UART_4, STM_PIN_DATA(STM_MODE_AF_PP, GPIO_PULLUP, GPIO_AF5_UART4)},
    {PC_12, UART_5, STM_PIN_DATA(STM_MODE_AF_PP, GPIO_PULLUP, GPIO_AF5_UART5)},
    {NC,    NC,     0}
};

const PinMap PinMap_UART_RX[] = {
    {PA_3,  UART_2, STM_PIN_DATA(STM_MODE_AF_PP, GPIO_PULLUP, GPIO_AF7_USART2)},
    {PA_10, UART_1, STM_PIN_DATA(STM_MODE_AF_PP, GPIO_PULLUP, GPIO_AF7_USART1)},
    {PA_15, UART_2, STM_PIN_DATA(STM_MODE_AF_PP, GPIO_PULLUP, GPIO_AF7_USART2)},
    {PB_4,  UART_2, STM_PIN_DATA(STM_MODE_AF_PP, GPIO_PULLUP, GPIO_AF7_USART2)},
    {PB_7,  UART_1, STM_PIN_DATA(STM_MODE_AF_PP, GPIO_PULLUP, GPIO_AF7_USART1)},
    {PB_11, UART_3, STM_PIN_DATA(STM_MODE_AF_PP, GPIO_PULLUP, GPIO_AF7_USART3)},
    {PC_11, UART_4, STM_PIN_DATA(STM_MODE_AF_PP, GPIO_PULLUP, GPIO_AF5_UART4)},
    {PD_2,  UART_5, STM_PIN_DATA(STM_MODE_AF_PP, GPIO_PULLUP, GPIO_AF5_UART5)},
    {NC,    NC,     0}
};

//*** SPI ***

const PinMap PinMap_SPI_MOSI[] = {
    {PA_7,  SPI_1, STM_PIN_DATA(STM_MODE_AF_PP, GPIO_PULLUP, GPIO_AF5_SPI1)},
    //{PB_5,  SPI_1, STM_PIN_DATA(STM_MODE_AF_PP, GPIO_PULLUP, GPIO_AF5_SPI1)},
    {PB_5,  SPI_3, STM_PIN_DATA(STM_MODE_AF_PP, GPIO_PULLUP, GPIO_AF6_SPI3)},
    {PB_15, SPI_2, STM_PIN_DATA(STM_MODE_AF_PP, GPIO_PULLUP, GPIO_AF5_SPI2)},
    {PC_12, SPI_3, STM_PIN_DATA(STM_MODE_AF_PP, GPIO_PULLUP, GPIO_AF6_SPI3)},
    {NC,    NC,    0}
};

const PinMap PinMap_SPI_MISO[] = {
    {PA_6,  SPI_1, STM_PIN_DATA(STM_MODE_AF_PP, GPIO_PULLUP, GPIO_AF5_SPI1)},
    //{PB_4,  SPI_1, STM_PIN_DATA(STM_MODE_AF_PP, GPIO_PULLUP, GPIO_AF5_SPI1)},
    {PB_4,  SPI_3, STM_PIN_DATA(STM_MODE_AF_PP, GPIO_PULLUP, GPIO_AF6_SPI3)},
    {PB_14, SPI_2, STM_PIN_DATA(STM_MODE_AF_PP, GPIO_PULLUP, GPIO_AF5_SPI2)},
    {PC_11, SPI_3, STM_PIN_DATA(STM_MODE_AF_PP, GPIO_PULLUP, GPIO_AF6_SPI3)},
    {NC,    NC,    0}
};

const PinMap PinMap_SPI_SCLK[] = {
    {PA_5,  SPI_1, STM_PIN_DATA(STM_MODE_AF_PP, GPIO_PULLUP, GPIO_AF5_SPI1)},
    //{PB_3,  SPI_1, STM_PIN_DATA(STM_MODE_AF_PP, GPIO_PULLUP, GPIO_AF5_SPI1)},
    {PB_3,  SPI_3, STM_PIN_DATA(STM_MODE_AF_PP, GPIO_PULLUP, GPIO_AF6_SPI3)},
    {PB_13, SPI_2, STM_PIN_DATA(STM_MODE_AF_PP, GPIO_PULLUP, GPIO_AF5_SPI2)},
    {PC_10, SPI_3, STM_PIN_DATA(STM_MODE_AF_PP, GPIO_PULLUP, GPIO_AF6_SPI3)},
    {PF_9,  SPI_2, STM_PIN_DATA(STM_MODE_AF_PP, GPIO_PULLUP, GPIO_AF5_SPI2)},
    {PF_10, SPI_2, STM_PIN_DATA(STM_MODE_AF_PP, GPIO_PULLUP, GPIO_AF5_SPI2)},
    {NC,    NC,    0}
};

const PinMap PinMap_SPI_SSEL[] = {
    {PA_4,  SPI_1, STM_PIN_DATA(STM_MODE_AF_PP, GPIO_PULLUP, GPIO_AF5_SPI1)},
    //{PA_4,  SPI_3, STM_PIN_DATA(STM_MODE_AF_PP, GPIO_PULLUP, GPIO_AF6_SPI3)},
    //{PA_15, SPI_1, STM_PIN_DATA(STM_MODE_AF_PP, GPIO_PULLUP, GPIO_AF5_SPI1)},
    {PA_15, SPI_3, STM_PIN_DATA(STM_MODE_AF_PP, GPIO_PULLUP, GPIO_AF6_SPI3)},
    {PB_12, SPI_2, STM_PIN_DATA(STM_MODE_AF_PP, GPIO_PULLUP, GPIO_AF5_SPI2)},
    {PD_15, SPI_2, STM_PIN_DATA(STM_MODE_AF_PP, GPIO_PULLUP, GPIO_AF6_SPI2)},
    {NC,    NC,    0}
};
