nickmolo/ECE477/Software/display/mbed-src/targets/hal/TARGET_STM/TARGET_STM32L4/TARGET_DISCO_L476VG/PeripheralPins.c

/* mbed Microcontroller Library
 *******************************************************************************
 * Copyright (c) 2015, STMicroelectronics
 * All rights reserved.
 *
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
 * THIS SOFTWARE IS PROVIDED BY THE COPYRIGHT HOLDERS AND CONTRIBUTORS "AS IS"
 * AND ANY EXPRESS OR IMPLIED WARRANTIES, INCLUDING, BUT NOT LIMITED TO, THE
 * IMPLIED WARRANTIES OF MERCHANTABILITY AND FITNESS FOR A PARTICULAR PURPOSE ARE
 * DISCLAIMED. IN NO EVENT SHALL THE COPYRIGHT HOLDER OR CONTRIBUTORS BE LIABLE
 * FOR ANY DIRECT, INDIRECT, INCIDENTAL, SPECIAL, EXEMPLARY, OR CONSEQUENTIAL
 * DAMAGES (INCLUDING, BUT NOT LIMITED TO, PROCUREMENT OF SUBSTITUTE GOODS OR
 * SERVICES; LOSS OF USE, DATA, OR PROFITS; OR BUSINESS INTERRUPTION) HOWEVER
 * CAUSED AND ON ANY THEORY OF LIABILITY, WHETHER IN CONTRACT, STRICT LIABILITY,
 * OR TORT (INCLUDING NEGLIGENCE OR OTHERWISE) ARISING IN ANY WAY OUT OF THE USE
 * OF THIS SOFTWARE, EVEN IF ADVISED OF THE POSSIBILITY OF SUCH DAMAGE.
 *******************************************************************************
 */

#include "PeripheralPins.h"

// =====
// Note: Commented lines are alternative possibilities which are not used per default.
//       If you change them, you will have also to modify the corresponding xxx_api.c file
//       for pwmout, analogin, analogout, ...
// =====

//*** ADC ***

const PinMap PinMap_ADC[] = {
    {PA_0,  ADC_1, STM_PIN_DATA_EXT(STM_MODE_ANALOG_ADC_CONTROL, GPIO_NOPULL, 0,  5, 0)}, // IN5
    {PA_1,  ADC_1, STM_PIN_DATA_EXT(STM_MODE_ANALOG_ADC_CONTROL, GPIO_NOPULL, 0,  6, 0)}, // IN6
    {PA_2,  ADC_1, STM_PIN_DATA_EXT(STM_MODE_ANALOG_ADC_CONTROL, GPIO_NOPULL, 0,  7, 0)}, // IN7
    {PA_3,  ADC_1, STM_PIN_DATA_EXT(STM_MODE_ANALOG_ADC_CONTROL, GPIO_NOPULL, 0,  8, 0)}, // IN8
    {PA_4,  ADC_1, STM_PIN_DATA_EXT(STM_MODE_ANALOG_ADC_CONTROL, GPIO_NOPULL, 0,  9, 0)}, // IN9
    {PA_5,  ADC_1, STM_PIN_DATA_EXT(STM_MODE_ANALOG_ADC_CONTROL, GPIO_NOPULL, 0, 10, 0)}, // IN10
    {PA_6,  ADC_1, STM_PIN_DATA_EXT(STM_MODE_ANALOG_ADC_CONTROL, GPIO_NOPULL, 0, 11, 0)}, // IN11
    {PA_7,  ADC_1, STM_PIN_DATA_EXT(STM_MODE_ANALOG_ADC_CONTROL, GPIO_NOPULL, 0, 12, 0)}, // IN12
    {PB_0,  ADC_1, STM_PIN_DATA_EXT(STM_MODE_ANALOG_ADC_CONTROL, GPIO_NOPULL, 0, 15, 0)}, // IN15
    {PB_1,  ADC_1, STM_PIN_DATA_EXT(STM_MODE_ANALOG_ADC_CONTROL, GPIO_NOPULL, 0, 16, 0)}, // IN16
    {PC_0,  ADC_1, STM_PIN_DATA_EXT(STM_MODE_ANALOG_ADC_CONTROL, GPIO_NOPULL, 0,  1, 0)}, // IN1
    {PC_1,  ADC_1, STM_PIN_DATA_EXT(STM_MODE_ANALOG_ADC_CONTROL, GPIO_NOPULL, 0,  2, 0)}, // IN2
    {PC_2,  ADC_1, STM_PIN_DATA_EXT(STM_MODE_ANALOG_ADC_CONTROL, GPIO_NOPULL, 0,  3, 0)}, // IN3
    {PC_3,  ADC_1, STM_PIN_DATA_EXT(STM_MODE_ANALOG_ADC_CONTROL, GPIO_NOPULL, 0,  4, 0)}, // IN4
    {PC_4,  ADC_1, STM_PIN_DATA_EXT(STM_MODE_ANALOG_ADC_CONTROL, GPIO_NOPULL, 0, 13, 0)}, // IN13
    {PC_5,  ADC_1, STM_PIN_DATA_EXT(STM_MODE_ANALOG_ADC_CONTROL, GPIO_NOPULL, 0, 14, 0)}, // IN14
    {NC,    NC,    0}
};

//*** DAC ***

const PinMap PinMap_DAC[] = {
    {PA_4, DAC_1, STM_PIN_DATA_EXT(STM_MODE_ANALOG, GPIO_NOPULL, 0, 1, 0)}, // OUT1
    {PA_5, DAC_1, STM_PIN_DATA_EXT(STM_MODE_ANALOG, GPIO_NOPULL, 0, 2, 0)}, // OUT2
    {NC,   NC,    0}
};

//*** I2C ***

const PinMap PinMap_I2C_SDA[] = {
    {PB_7,  I2C_1, STM_PIN_DATA(STM_MODE_AF_OD, GPIO_NOPULL, GPIO_AF4_I2C1)},
    {PB_9,  I2C_1, STM_PIN_DATA(STM_MODE_AF_OD, GPIO_NOPULL, GPIO_AF4_I2C1)},
    {PB_11, I2C_2, STM_PIN_DATA(STM_MODE_AF_OD, GPIO_NOPULL, GPIO_AF4_I2C2)},
    {PB_14, I2C_2, STM_PIN_DATA(STM_MODE_AF_OD, GPIO_NOPULL, GPIO_AF4_I2C2)},
    {PC_1,  I2C_3, STM_PIN_DATA(STM_MODE_AF_OD, GPIO_NOPULL, GPIO_AF4_I2C3)},
    {NC,    NC,    0}
};

const PinMap PinMap_I2C_SCL[] = {
    {PB_6,  I2C_1, STM_PIN_DATA(STM_MODE_AF_OD, GPIO_NOPULL, GPIO_AF4_I2C1)},
    {PB_8,  I2C_1, STM_PIN_DATA(STM_MODE_AF_OD, GPIO_NOPULL, GPIO_AF4_I2C1)}, // Warning: connected also to GYRO_INT2 pin
    {PB_10, I2C_2, STM_PIN_DATA(STM_MODE_AF_OD, GPIO_NOPULL, GPIO_AF4_I2C2)},
    {PB_13, I2C_2, STM_PIN_DATA(STM_MODE_AF_OD, GPIO_NOPULL, GPIO_AF4_I2C2)},
    {PC_0,  I2C_3, STM_PIN_DATA(STM_MODE_AF_OD, GPIO_NOPULL, GPIO_AF4_I2C3)},
    {NC,    NC,    0}
};

//*** PWM ***

// Warning: TIM5 cannot be used because already used by the us_ticker.
const PinMap PinMap_PWM[] = {
    {PA_0,  PWM_2,  STM_PIN_DATA_EXT(STM_MODE_AF_PP, GPIO_PULLUP, GPIO_AF1_TIM2, 1, 0)},  // TIM2_CH1
//  {PA_0,  PWM_5,  STM_PIN_DATA_EXT(STM_MODE_AF_PP, GPIO_PULLUP, GPIO_AF2_TIM5, 1, 0)},  // TIM5_CH1 (used by us_ticker)
    {PA_1,  PWM_2,  STM_PIN_DATA_EXT(STM_MODE_AF_PP, GPIO_PULLUP, GPIO_AF1_TIM2, 2, 0)},  // TIM2_CH2
//  {PA_1,  PWM_5,  STM_PIN_DATA_EXT(STM_MODE_AF_PP, GPIO_PULLUP, GPIO_AF2_TIM5, 2, 0)},  // TIM5_CH2 (used by us_ticker)
//  {PA_1,  PWM_15, STM_PIN_DATA_EXT(STM_MODE_AF_PP, GPIO_PULLUP, GPIO_AF14_TIM15, 1, 1)},// TIM15_CH1N
    {PA_2,  PWM_2,  STM_PIN_DATA_EXT(STM_MODE_AF_PP, GPIO_PULLUP, GPIO_AF1_TIM2, 3, 0)},  // TIM2_CH3
//  {PA_2,  PWM_5,  STM_PIN_DATA_EXT(STM_MODE_AF_PP, GPIO_PULLUP, GPIO_AF2_TIM5, 3, 0)},  // TIM5_CH3 (used by us_ticker)
//  {PA_2,  PWM_15, STM_PIN_DATA_EXT(STM_MODE_AF_PP, GPIO_PULLUP, GPIO_AF14_TIM15, 1, 0)},// TIM15_CH1
    {PA_3,  PWM_2,  STM_PIN_DATA_EXT(STM_MODE_AF_PP, GPIO_PULLUP, GPIO_AF1_TIM2, 4, 0)},  // TIM2_CH4
//  {PA_3,  PWM_5,  STM_PIN_DATA_EXT(STM_MODE_AF_PP, GPIO_PULLUP, GPIO_AF2_TIM5, 4, 0)},  // TIM5_CH4 (used by us_ticker)
//  {PA_3,  PWM_15, STM_PIN_DATA_EXT(STM_MODE_AF_PP, GPIO_PULLUP, GPIO_AF14_TIM15, 2, 0)},// TIM15_CH2
    {PA_5,  PWM_2,  STM_PIN_DATA_EXT(STM_MODE_AF_PP, GPIO_PULLUP, GPIO_AF1_TIM2, 1, 0)},  // TIM2_CH1
//  {PA_5,  PWM_8,  STM_PIN_DATA_EXT(STM_MODE_AF_PP, GPIO_PULLUP, GPIO_AF3_TIM8, 1, 1)},  // TIM8_CH1N
    {PA_6,  PWM_3,  STM_PIN_DATA_EXT(STM_MODE_AF_PP, GPIO_PULLUP, GPIO_AF2_TIM3, 1, 0)},  // TIM3_CH1
//  {PA_6,  PWM_16, STM_PIN_DATA_EXT(STM_MODE_AF_PP, GPIO_PULLUP, GPIO_AF14_TIM16, 1, 0)},// TIM16_CH1
    {PA_7,  PWM_3,  STM_PIN_DATA_EXT(STM_MODE_AF_PP, GPIO_PULLUP, GPIO_AF2_TIM3, 2, 0)},  // TIM3_CH2
//  {PA_7,  PWM_1,  STM_PIN_DATA_EXT(STM_MODE_AF_PP, GPIO_PULLUP, GPIO_AF1_TIM1, 1, 1)},  // TIM1_CH1N
//  {PA_7,  PWM_8,  STM_PIN_DATA_EXT(STM_MODE_AF_PP, GPIO_PULLUP, GPIO_AF3_TIM8, 1, 1)},  // TIM8_CH1N
//  {PA_7,  PWM_17, STM_PIN_DATA_EXT(STM_MODE_AF_PP, GPIO_PULLUP, GPIO_AF14_TIM17, 1, 0)},// TIM17_CH1
    {PA_8,  PWM_1,  STM_PIN_DATA_EXT(STM_MODE_AF_PP, GPIO_PULLUP, GPIO_AF1_TIM1, 1, 0)},  // TIM1_CH1
    {PA_9,  PWM_1,  STM_PIN_DATA_EXT(STM_MODE_AF_PP, GPIO_PULLUP, GPIO_AF1_TIM1, 2, 0)},  // TIM1_CH2
    {PA_10, PWM_1,  STM_PIN_DATA_EXT(STM_MODE_AF_PP, GPIO_PULLUP, GPIO_AF1_TIM1, 3, 0)},  // TIM1_CH3
    {PA_11, PWM_1,  STM_PIN_DATA_EXT(STM_MODE_AF_PP, GPIO_PULLUP, GPIO_AF1_TIM1, 4, 0)},  // TIM1_CH4
    {PA_15, PWM_2,  STM_PIN_DATA_EXT(STM_MODE_AF_PP, GPIO_PULLUP, GPIO_AF1_TIM2, 1, 0)},  // TIM2_CH1
    {PB_0,  PWM_3,  STM_PIN_DATA_EXT(STM_MODE_AF_PP, GPIO_PULLUP, GPIO_AF2_TIM3, 3, 0)},  // TIM3_CH3
//  {PB_0,  PWM_1,  STM_PIN_DATA_EXT(STM_MODE_AF_PP, GPIO_PULLUP, GPIO_AF1_TIM1, 2, 1)},  // TIM1_CH2N
//  {PB_0,  PWM_8,  STM_PIN_DATA_EXT(STM_MODE_AF_PP, GPIO_PULLUP, GPIO_AF3_TIM8, 2, 1)},  // TIM8_CH2N
    {PB_1,  PWM_3,  STM_PIN_DATA_EXT(STM_MODE_AF_PP, GPIO_PULLUP, GPIO_AF2_TIM3, 4, 0)},  // TIM3_CH4
//  {PB_1,  PWM_1,  STM_PIN_DATA_EXT(STM_MODE_AF_PP, GPIO_PULLUP, GPIO_AF1_TIM1, 3, 1)},  // TIM1_CH3N
//  {PB_1,  PWM_8,  STM_PIN_DATA_EXT(STM_MODE_AF_PP, GPIO_PULLUP, GPIO_AF3_TIM8, 3, 1)},  // TIM8_CH3N
    {PB_3,  PWM_2,  STM_PIN_DATA_EXT(STM_MODE_AF_PP, GPIO_PULLUP, GPIO_AF1_TIM2, 2, 0)},  // TIM2_CH2
    {PB_4,  PWM_3,  STM_PIN_DATA_EXT(STM_MODE_AF_PP, GPIO_PULLUP, GPIO_AF2_TIM3, 1, 0)},  // TIM3_CH1
    {PB_5,  PWM_3,  STM_PIN_DATA_EXT(STM_MODE_AF_PP, GPIO_PULLUP, GPIO_AF2_TIM3, 2, 0)},  // TIM3_CH2
    {PB_6,  PWM_4,  STM_PIN_DATA_EXT(STM_MODE_AF_PP, GPIO_PULLUP, GPIO_AF2_TIM4, 1, 0)},  // TIM4_CH1
//  {PB_6,  PWM_16, STM_PIN_DATA_EXT(STM_MODE_AF_PP, GPIO_PULLUP, GPIO_AF14_TIM16, 1, 1)},// TIM16_CH1N
    {PB_7,  PWM_4,  STM_PIN_DATA_EXT(STM_MODE_AF_PP, GPIO_PULLUP, GPIO_AF2_TIM4, 2, 0)},  // TIM4_CH2
//  {PB_7,  PWM_17, STM_PIN_DATA_EXT(STM_MODE_AF_PP, GPIO_PULLUP, GPIO_AF14_TIM17, 1, 1)},// TIM17_CH1N
    {PB_8,  PWM_4,  STM_PIN_DATA_EXT(STM_MODE_AF_PP, GPIO_PULLUP, GPIO_AF2_TIM4, 3, 0)},  // TIM4_CH3 - Warning: connected also to GYRO_INT2 pin
//  {PB_6,  PWM_16, STM_PIN_DATA_EXT(STM_MODE_AF_PP, GPIO_PULLUP, GPIO_AF14_TIM16, 1, 0)},// TIM16_CH1
    {PB_9,  PWM_4,  STM_PIN_DATA_EXT(STM_MODE_AF_PP, GPIO_PULLUP, GPIO_AF2_TIM4, 4, 0)},  // TIM4_CH4 - Warning: connected also to LCD_COM3 pin
//  {PB_9,  PWM_17, STM_PIN_DATA_EXT(STM_MODE_AF_PP, GPIO_PULLUP, GPIO_AF14_TIM17, 1, 0)},// TIM17_CH1
    {PB_10, PWM_2,  STM_PIN_DATA_EXT(STM_MODE_AF_PP, GPIO_PULLUP, GPIO_AF1_TIM2, 3, 0)},  // TIM2_CH3
    {PB_11, PWM_2,  STM_PIN_DATA_EXT(STM_MODE_AF_PP, GPIO_PULLUP, GPIO_AF1_TIM2, 4, 0)},  // TIM2_CH4
    {PB_13, PWM_1,  STM_PIN_DATA_EXT(STM_MODE_AF_PP, GPIO_PULLUP, GPIO_AF1_TIM1, 1, 1)},  // TIM1_CH1N
//  {PB_13, PWM_15, STM_PIN_DATA_EXT(STM_MODE_AF_PP, GPIO_PULLUP, GPIO_AF14_TIM15, 1, 1)},// TIM15_CH1N
    {PB_14, PWM_1,  STM_PIN_DATA_EXT(STM_MODE_AF_PP, GPIO_PULLUP, GPIO_AF1_TIM1, 2, 1)},  // TIM1_CH2N
//  {PB_14, PWM_15, STM_PIN_DATA_EXT(STM_MODE_AF_PP, GPIO_PULLUP, GPIO_AF14_TIM15, 1, 0)},// TIM15_CH1
//  {PB_14, PWM_8,  STM_PIN_DATA_EXT(STM_MODE_AF_PP, GPIO_PULLUP, GPIO_AF3_TIM8, 2, 1)},  // TIM8_CH2N
    {PB_15, PWM_1,  STM_PIN_DATA_EXT(STM_MODE_AF_PP, GPIO_PULLUP, GPIO_AF1_TIM1, 3, 1)},  // TIM1_CH3N
//  {PB_15, PWM_15, STM_PIN_DATA_EXT(STM_MODE_AF_PP, GPIO_PULLUP, GPIO_AF14_TIM15, 2, 0)},// TIM15_CH2
//  {PB_15, PWM_8,  STM_PIN_DATA_EXT(STM_MODE_AF_PP, GPIO_PULLUP, GPIO_AF3_TIM8, 3, 1)},  // TIM8_CH3N
    {PC_6,  PWM_8,  STM_PIN_DATA_EXT(STM_MODE_AF_PP, GPIO_PULLUP, GPIO_AF3_TIM8, 1, 0)},  // TIM8_CH1
//  {PC_6,  PWM_3,  STM_PIN_DATA_EXT(STM_MODE_AF_PP, GPIO_PULLUP, GPIO_AF2_TIM3, 1, 0)},  // TIM3_CH1
    {PC_7,  PWM_8,  STM_PIN_DATA_EXT(STM_MODE_AF_PP, GPIO_PULLUP, GPIO_AF3_TIM8, 2, 0)},  // TIM8_CH2
//  {PC_7,  PWM_3,  STM_PIN_DATA_EXT(STM_MODE_AF_PP, GPIO_PULLUP, GPIO_AF2_TIM3, 2, 0)},  // TIM3_CH2
    {PC_8,  PWM_8,  STM_PIN_DATA_EXT(STM_MODE_AF_PP, GPIO_PULLUP, GPIO_AF3_TIM8, 3, 0)},  // TIM8_CH3
//  {PC_8,  PWM_3,  STM_PIN_DATA_EXT(STM_MODE_AF_PP, GPIO_PULLUP, GPIO_AF2_TIM3, 3, 0)},  // TIM3_CH3
    {PC_9,  PWM_8,  STM_PIN_DATA_EXT(STM_MODE_AF_PP, GPIO_PULLUP, GPIO_AF3_TIM8, 4, 0)},  // TIM8_CH4
//  {PC_9,  PWM_3,  STM_PIN_DATA_EXT(STM_MODE_AF_PP, GPIO_PULLUP, GPIO_AF2_TIM3, 4, 0)},  // TIM3_CH4
    {PE_8,  PWM_1,  STM_PIN_DATA_EXT(STM_MODE_AF_PP, GPIO_PULLUP, GPIO_AF1_TIM1, 1, 1)},  // TIM1_CH1N - Warning: connected also to LED1
    {PE_10, PWM_1,  STM_PIN_DATA_EXT(STM_MODE_AF_PP, GPIO_PULLUP, GPIO_AF1_TIM1, 2, 1)},  // TIM1_CH2N
    {PE_11, PWM_1,  STM_PIN_DATA_EXT(STM_MODE_AF_PP, GPIO_PULLUP, GPIO_AF1_TIM1, 2, 0)},  // TIM1_CH2
    {PE_12, PWM_1,  STM_PIN_DATA_EXT(STM_MODE_AF_PP, GPIO_PULLUP, GPIO_AF1_TIM1, 3, 1)},  // TIM1_CH3N
    {PE_13, PWM_1,  STM_PIN_DATA_EXT(STM_MODE_AF_PP, GPIO_PULLUP, GPIO_AF1_TIM1, 3, 0)},  // TIM1_CH3
    {PE_14, PWM_1,  STM_PIN_DATA_EXT(STM_MODE_AF_PP, GPIO_PULLUP, GPIO_AF1_TIM1, 4, 0)},  // TIM1_CH4
    {NC,    NC,     0}
};

//*** SERIAL ***

const PinMap PinMap_UART_TX[] = {
    {PA_0,  UART_4, STM_PIN_DATA(STM_MODE_AF_PP, GPIO_PULLUP, GPIO_AF8_UART4)},
    {PA_2,  UART_2, STM_PIN_DATA(STM_MODE_AF_PP, GPIO_PULLUP, GPIO_AF7_USART2)}, // Warning: UART_2 already used by STDIO
    {PA_9,  UART_1, STM_PIN_DATA(STM_MODE_AF_PP, GPIO_PULLUP, GPIO_AF7_USART1)},
    {PB_6,  UART_1, STM_PIN_DATA(STM_MODE_AF_PP, GPIO_PULLUP, GPIO_AF7_USART1)},
    {PB_10, UART_3, STM_PIN_DATA(STM_MODE_AF_PP, GPIO_PULLUP, GPIO_AF7_USART3)},
//  {PB_11, LPUART_1, STM_PIN_DATA(STM_MODE_AF_PP, GPIO_PULLUP, GPIO_AF8_LPUART1)}, // Warning: Already used by UART_RX
    {PC_1,  LPUART_1, STM_PIN_DATA(STM_MODE_AF_PP, GPIO_PULLUP, GPIO_AF8_LPUART1)},
    {PC_4,  UART_3, STM_PIN_DATA(STM_MODE_AF_PP, GPIO_PULLUP, GPIO_AF7_USART3)},
    {PC_10, UART_3, STM_PIN_DATA(STM_MODE_AF_PP, GPIO_PULLUP, GPIO_AF7_USART3)},
//  {PC_10, UART_4, STM_PIN_DATA(STM_MODE_AF_PP, GPIO_PULLUP, GPIO_AF8_UART4)},
    {PC_12, UART_5, STM_PIN_DATA(STM_MODE_AF_PP, GPIO_PULLUP, GPIO_AF8_UART5)},
    {PD_5,  UART_2, STM_PIN_DATA(STM_MODE_AF_PP, GPIO_PULLUP, GPIO_AF7_USART2)}, // STDIO_TX
    {NC,    NC,     0}
};

const PinMap PinMap_UART_RX[] = {
    {PA_1,  UART_4, STM_PIN_DATA(STM_MODE_AF_PP, GPIO_PULLUP, GPIO_AF8_UART4)},
    {PA_3,  UART_2, STM_PIN_DATA(STM_MODE_AF_PP, GPIO_PULLUP, GPIO_AF7_USART2)}, // Warning: UART_2 already used by STDIO
    {PA_10, UART_1, STM_PIN_DATA(STM_MODE_AF_PP, GPIO_PULLUP, GPIO_AF7_USART1)},
    {PB_7,  UART_1, STM_PIN_DATA(STM_MODE_AF_PP, GPIO_PULLUP, GPIO_AF7_USART1)},
//  {PB_10, LPUART_1, STM_PIN_DATA(STM_MODE_AF_PP, GPIO_PULLUP, GPIO_AF8_LPUART1)}, // Warning: Already used by UART_TX
    {PB_11, UART_3, STM_PIN_DATA(STM_MODE_AF_PP, GPIO_PULLUP, GPIO_AF7_USART3)},
    {PC_0,  LPUART_1, STM_PIN_DATA(STM_MODE_AF_PP, GPIO_PULLUP, GPIO_AF8_LPUART1)},
    {PC_5,  UART_3, STM_PIN_DATA(STM_MODE_AF_PP, GPIO_PULLUP, GPIO_AF7_USART3)},
    {PC_11, UART_3, STM_PIN_DATA(STM_MODE_AF_PP, GPIO_PULLUP, GPIO_AF7_USART3)},
//  {PC_11, UART_4, STM_PIN_DATA(STM_MODE_AF_PP, GPIO_PULLUP, GPIO_AF8_UART4)},
    {PD_2,  UART_5, STM_PIN_DATA(STM_MODE_AF_PP, GPIO_PULLUP, GPIO_AF8_UART5)},
    {PD_6,  UART_2, STM_PIN_DATA(STM_MODE_AF_PP, GPIO_PULLUP, GPIO_AF7_USART2)}, // STDIO_RX
    {NC,    NC,     0}
};

//*** SPI ***

const PinMap PinMap_SPI_MOSI[] = {
    {PA_7,  SPI_1, STM_PIN_DATA(STM_MODE_AF_PP, GPIO_PULLUP, GPIO_AF5_SPI1)},
    {PB_5,  SPI_1, STM_PIN_DATA(STM_MODE_AF_PP, GPIO_PULLUP, GPIO_AF5_SPI1)},
    {PB_15, SPI_2, STM_PIN_DATA(STM_MODE_AF_PP, GPIO_PULLUP, GPIO_AF5_SPI2)},
    {PC_3,  SPI_2, STM_PIN_DATA(STM_MODE_AF_PP, GPIO_PULLUP, GPIO_AF5_SPI2)},
    {PC_12, SPI_3, STM_PIN_DATA(STM_MODE_AF_PP, GPIO_PULLUP, GPIO_AF6_SPI3)},
    {PE_15, SPI_1, STM_PIN_DATA(STM_MODE_AF_PP, GPIO_PULLUP, GPIO_AF5_SPI1)},
    {NC,    NC,    0}
};

const PinMap PinMap_SPI_MISO[] = {
    {PA_6,  SPI_1, STM_PIN_DATA(STM_MODE_AF_PP, GPIO_PULLUP, GPIO_AF5_SPI1)},
    {PB_4,  SPI_1, STM_PIN_DATA(STM_MODE_AF_PP, GPIO_PULLUP, GPIO_AF5_SPI1)},
    {PB_14, SPI_2, STM_PIN_DATA(STM_MODE_AF_PP, GPIO_PULLUP, GPIO_AF5_SPI2)},
    {PC_2,  SPI_2, STM_PIN_DATA(STM_MODE_AF_PP, GPIO_PULLUP, GPIO_AF5_SPI2)},
    {PC_11, SPI_3, STM_PIN_DATA(STM_MODE_AF_PP, GPIO_PULLUP, GPIO_AF6_SPI3)},
    {PE_14, SPI_1, STM_PIN_DATA(STM_MODE_AF_PP, GPIO_PULLUP, GPIO_AF5_SPI1)},
    {NC,    NC,    0}
};

const PinMap PinMap_SPI_SCLK[] = {
    {PA_5,  SPI_1, STM_PIN_DATA(STM_MODE_AF_PP, GPIO_PULLUP, GPIO_AF5_SPI1)}, // Warning: does not work on this board due to other components connected on this pin
    {PB_3,  SPI_1, STM_PIN_DATA(STM_MODE_AF_PP, GPIO_PULLUP, GPIO_AF5_SPI1)},
    {PB_10, SPI_2, STM_PIN_DATA(STM_MODE_AF_PP, GPIO_PULLUP, GPIO_AF5_SPI2)},
    {PB_13, SPI_2, STM_PIN_DATA(STM_MODE_AF_PP, GPIO_PULLUP, GPIO_AF5_SPI2)},
    {PC_10, SPI_3, STM_PIN_DATA(STM_MODE_AF_PP, GPIO_PULLUP, GPIO_AF6_SPI3)},
    {PE_13, SPI_1, STM_PIN_DATA(STM_MODE_AF_PP, GPIO_PULLUP, GPIO_AF5_SPI1)},
    {NC,    NC,    0}
};

const PinMap PinMap_SPI_SSEL[] = {
    {PA_4,  SPI_1, STM_PIN_DATA(STM_MODE_AF_PP, GPIO_PULLUP, GPIO_AF5_SPI1)},
//  {PA_4,  SPI_3, STM_PIN_DATA(STM_MODE_AF_PP, GPIO_PULLUP, GPIO_AF6_SPI3)},
    {PA_15, SPI_1, STM_PIN_DATA(STM_MODE_AF_PP, GPIO_PULLUP, GPIO_AF5_SPI1)},
//  {PA_15, SPI_3, STM_PIN_DATA(STM_MODE_AF_PP, GPIO_PULLUP, GPIO_AF6_SPI3)},
    {PB_9,  SPI_2, STM_PIN_DATA(STM_MODE_AF_PP, GPIO_PULLUP, GPIO_AF5_SPI2)},
    {PB_12, SPI_2, STM_PIN_DATA(STM_MODE_AF_PP, GPIO_PULLUP, GPIO_AF5_SPI2)},
    {PE_12, SPI_1, STM_PIN_DATA(STM_MODE_AF_PP, GPIO_PULLUP, GPIO_AF5_SPI1)},
    {NC,    NC,    0}
};
