nickmolo/ECE477/Software/display/mbed-src/targets/hal/TARGET_STM/TARGET_STM32F7/TARGET_DISCO_F746NG/PeripheralPins.c

/* mbed Microcontroller Library
 *******************************************************************************
 * Copyright (c) 2015, STMicroelectronics
 * All rights reserved.
 *
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
 * THIS SOFTWARE IS PROVIDED BY THE COPYRIGHT HOLDERS AND CONTRIBUTORS "AS IS"
 * AND ANY EXPRESS OR IMPLIED WARRANTIES, INCLUDING, BUT NOT LIMITED TO, THE
 * IMPLIED WARRANTIES OF MERCHANTABILITY AND FITNESS FOR A PARTICULAR PURPOSE ARE
 * DISCLAIMED. IN NO EVENT SHALL THE COPYRIGHT HOLDER OR CONTRIBUTORS BE LIABLE
 * FOR ANY DIRECT, INDIRECT, INCIDENTAL, SPECIAL, EXEMPLARY, OR CONSEQUENTIAL
 * DAMAGES (INCLUDING, BUT NOT LIMITED TO, PROCUREMENT OF SUBSTITUTE GOODS OR
 * SERVICES; LOSS OF USE, DATA, OR PROFITS; OR BUSINESS INTERRUPTION) HOWEVER
 * CAUSED AND ON ANY THEORY OF LIABILITY, WHETHER IN CONTRACT, STRICT LIABILITY,
 * OR TORT (INCLUDING NEGLIGENCE OR OTHERWISE) ARISING IN ANY WAY OUT OF THE USE
 * OF THIS SOFTWARE, EVEN IF ADVISED OF THE POSSIBILITY OF SUCH DAMAGE.
 *******************************************************************************
 */

#include "PeripheralPins.h"

// =============================================================================
// Notes:
// * Commented lines are alternative possibilities which are not used per default.
//   If you change them, you will have also to modify the corresponding xxx_api.c file
//   for pwmout, analogin, analogout, ...
// * Only the pins that are placed on the Arduino connector are described.
// =============================================================================

//*** ADC ***

const PinMap PinMap_ADC[] = {
    {PA_0,  ADC_3, STM_PIN_DATA_EXT(STM_MODE_ANALOG, GPIO_NOPULL, 0, 0, 0)}, // ADC3_IN0 - ARDUINO A0
    {PF_6,  ADC_3, STM_PIN_DATA_EXT(STM_MODE_ANALOG, GPIO_NOPULL, 0, 4, 0)}, // ADC3_IN4 - ARDUINO A5
    {PF_7,  ADC_3, STM_PIN_DATA_EXT(STM_MODE_ANALOG, GPIO_NOPULL, 0, 5, 0)}, // ADC3_IN5 - ARDUINO A4
    {PF_8,  ADC_3, STM_PIN_DATA_EXT(STM_MODE_ANALOG, GPIO_NOPULL, 0, 6, 0)}, // ADC3_IN6 - ARDUINO A3
    {PF_9,  ADC_3, STM_PIN_DATA_EXT(STM_MODE_ANALOG, GPIO_NOPULL, 0, 7, 0)}, // ADC3_IN7 - ARDUINO A2
    {PF_10, ADC_3, STM_PIN_DATA_EXT(STM_MODE_ANALOG, GPIO_NOPULL, 0, 8, 0)}, // ADC3_IN8 - ARDUINO A1
    {NC,    NC,    0}
};

//*** DAC ***

const PinMap PinMap_DAC[] = {
    {PA_4, DAC_1, STM_PIN_DATA_EXT(STM_MODE_ANALOG, GPIO_NOPULL, 0xFF, 1, 0)}, // DAC_OUT1
    {PA_5, DAC_1, STM_PIN_DATA_EXT(STM_MODE_ANALOG, GPIO_NOPULL, 0xFF, 2, 0)}, // DAC_OUT2
    {NC,   NC,    0}
};

//*** I2C ***

const PinMap PinMap_I2C_SDA[] = {
    {PB_9,  I2C_1, STM_PIN_DATA(STM_MODE_AF_OD, GPIO_NOPULL, GPIO_AF4_I2C1)}, // ARDUINO D14
    {NC,    NC,    0}
};

const PinMap PinMap_I2C_SCL[] = {
    {PB_8,  I2C_1, STM_PIN_DATA(STM_MODE_AF_OD, GPIO_NOPULL, GPIO_AF4_I2C1)}, // ARDUINO D15
    {NC,    NC,    0}
};

//*** PWM ***

const PinMap PinMap_PWM[] = {
    {PA_0,  PWM_2,  STM_PIN_DATA_EXT(STM_MODE_AF_PP, GPIO_PULLUP, GPIO_AF1_TIM2,  1, 0)}, // TIM2_CH1 - ARDUINO A0
//  {PA_0,  PWM_5,  STM_PIN_DATA_EXT(STM_MODE_AF_PP, GPIO_PULLUP, GPIO_AF2_TIM5,  1, 0)}, // TIM5_CH1 - ARDUINO A0 (used by us_ticker)
    {PA_8,  PWM_1,  STM_PIN_DATA_EXT(STM_MODE_AF_PP, GPIO_PULLUP, GPIO_AF1_TIM1,  1, 0)}, // TIM1_CH1 - ARDUINO D5
    {PA_15, PWM_2,  STM_PIN_DATA_EXT(STM_MODE_AF_PP, GPIO_PULLUP, GPIO_AF1_TIM2,  1, 0)}, // TIM2_CH1 - ARDUINO D9
    {PB_4,  PWM_3,  STM_PIN_DATA_EXT(STM_MODE_AF_PP, GPIO_PULLUP, GPIO_AF2_TIM3,  1, 0)}, // TIM3_CH1 - ARDUINO D3
    {PB_8,  PWM_4,  STM_PIN_DATA_EXT(STM_MODE_AF_PP, GPIO_PULLUP, GPIO_AF2_TIM4,  3, 0)}, // TIM4_CH3 - ARDUINO D15
//  {PB_8,  PWM_10, STM_PIN_DATA_EXT(STM_MODE_AF_PP, GPIO_PULLUP, GPIO_AF3_TIM1,  1, 0)}, // TIM10_CH1 - ARDUINO D15
    {PB_9,  PWM_4,  STM_PIN_DATA_EXT(STM_MODE_AF_PP, GPIO_PULLUP, GPIO_AF2_TIM4,  4, 0)}, // TIM4_CH4 - ARDUINO D14
//  {PB_9,  PWM_11, STM_PIN_DATA_EXT(STM_MODE_AF_PP, GPIO_PULLUP, GPIO_AF3_TIM11, 1, 0)}, // TIM11_CH1 - ARDUINO D14
//  {PB_14, PWM_1,  STM_PIN_DATA_EXT(STM_MODE_AF_PP, GPIO_PULLUP, GPIO_AF1_TIM1,  2, 1)}, // TIM1_CH2N - ARDUINO D12
//  {PB_14, PWM_8,  STM_PIN_DATA_EXT(STM_MODE_AF_PP, GPIO_PULLUP, GPIO_AF3_TIM8,  2, 1)}, // TIM8_CH2N - ARDUINO D12
    {PB_14, PWM_12, STM_PIN_DATA_EXT(STM_MODE_AF_PP, GPIO_PULLUP, GPIO_AF9_TIM12, 1, 0)}, // TIM12_CH1 - ARDUINO D12
//  {PB_15, PWM_1,  STM_PIN_DATA_EXT(STM_MODE_AF_PP, GPIO_PULLUP, GPIO_AF1_TIM1,  3, 1)}, // TIM1_CH3N - ARDUINO D11
//  {PB_15, PWM_8,  STM_PIN_DATA_EXT(STM_MODE_AF_PP, GPIO_PULLUP, GPIO_AF3_TIM8,  3, 1)}, // TIM8_CH3N - ARDUINO D11
    {PB_15, PWM_12, STM_PIN_DATA_EXT(STM_MODE_AF_PP, GPIO_PULLUP, GPIO_AF9_TIM12, 2, 0)}, // TIM12_CH2 - ARDUINO D11
//  {PC_6,  PWM_3,  STM_PIN_DATA_EXT(STM_MODE_AF_PP, GPIO_PULLUP, GPIO_AF2_TIM3,  1, 0)}, // TIM3_CH1 - ARDUINO D1
    {PC_6,  PWM_8,  STM_PIN_DATA_EXT(STM_MODE_AF_PP, GPIO_PULLUP, GPIO_AF3_TIM8,  1, 0)}, // TIM8_CH1 - ARDUINO D1
//  {PC_7,  PWM_3,  STM_PIN_DATA_EXT(STM_MODE_AF_PP, GPIO_PULLUP, GPIO_AF2_TIM3,  2, 0)}, // TIM3_CH2 - ARDUINO D0
    {PC_7,  PWM_8,  STM_PIN_DATA_EXT(STM_MODE_AF_PP, GPIO_PULLUP, GPIO_AF3_TIM8,  2, 0)}, // TIM8_CH2 - ARDUINO D0
    {PF_6,  PWM_10, STM_PIN_DATA_EXT(STM_MODE_AF_PP, GPIO_PULLUP, GPIO_AF3_TIM10, 1, 0)}, // TIM10_CH1 - ARDUINO A5
    {PF_7,  PWM_11, STM_PIN_DATA_EXT(STM_MODE_AF_PP, GPIO_PULLUP, GPIO_AF3_TIM11, 1, 0)}, // TIM11_CH1 - ARDUINO A4
    {PF_8,  PWM_13, STM_PIN_DATA_EXT(STM_MODE_AF_PP, GPIO_PULLUP, GPIO_AF9_TIM13, 1, 0)}, // TIM13_CH1 - ARDUINO A3
    {PF_9,  PWM_14, STM_PIN_DATA_EXT(STM_MODE_AF_PP, GPIO_PULLUP, GPIO_AF9_TIM14, 1, 0)}, // TIM14_CH1 - ARDUINO A2
    {PH_6,  PWM_12, STM_PIN_DATA_EXT(STM_MODE_AF_PP, GPIO_PULLUP, GPIO_AF9_TIM12, 1, 0)}, // TIM12_CH1 - ARDUINO D6
//  {PI_0,  PWM_5,  STM_PIN_DATA_EXT(STM_MODE_AF_PP, GPIO_PULLUP, GPIO_AF2_TIM5,  4, 0)}, // TIM5_CH4 - ARDUINO D10 (used by us_ticker)
    {PI_2,  PWM_8,  STM_PIN_DATA_EXT(STM_MODE_AF_PP, GPIO_PULLUP, GPIO_AF3_TIM8,  4, 0)}, // TIM8_CH4 - ARDUINO D8
    {NC,    NC,    0}
};

//*** SERIAL ***

const PinMap PinMap_UART_TX[] = {
    {PA_0,  UART_4, STM_PIN_DATA(STM_MODE_AF_PP, GPIO_PULLUP, GPIO_AF8_UART4)}, // ARDUINO A0
    {PA_9,  UART_1, STM_PIN_DATA(STM_MODE_AF_PP, GPIO_PULLUP, GPIO_AF7_USART1)}, // Virtual Com Port
    {PC_6,  UART_6, STM_PIN_DATA(STM_MODE_AF_PP, GPIO_PULLUP, GPIO_AF8_USART6)}, // ARDUINO D1
    {PF_7,  UART_7, STM_PIN_DATA(STM_MODE_AF_PP, GPIO_PULLUP, GPIO_AF8_UART7)}, // ARDUINO A4
    {NC,    NC,     0}
};

const PinMap PinMap_UART_RX[] = {
    {PB_7,  UART_1, STM_PIN_DATA(STM_MODE_AF_PP, GPIO_PULLUP, GPIO_AF7_USART1)}, // Virtual Com Port
    {PC_7,  UART_6, STM_PIN_DATA(STM_MODE_AF_PP, GPIO_PULLUP, GPIO_AF8_USART6)}, // ARDUINO D0
    {PF_6,  UART_7, STM_PIN_DATA(STM_MODE_AF_PP, GPIO_PULLUP, GPIO_AF8_UART7)}, // ARDUINO A5
    {NC,    NC,     0}
};

//*** SPI ***

const PinMap PinMap_SPI_MOSI[] = {
    {PB_15, SPI_2, STM_PIN_DATA(STM_MODE_AF_PP, GPIO_NOPULL, GPIO_AF5_SPI2)}, // ARDUINO D11
    {PF_9,  SPI_5, STM_PIN_DATA(STM_MODE_AF_PP, GPIO_NOPULL, GPIO_AF5_SPI5)}, // ARDUINO A2
    {PI_3,  SPI_2, STM_PIN_DATA(STM_MODE_AF_PP, GPIO_NOPULL, GPIO_AF5_SPI2)}, // ARDUINO D7
    {NC,    NC,    0}
};

const PinMap PinMap_SPI_MISO[] = {
    {PB_14, SPI_2, STM_PIN_DATA(STM_MODE_AF_PP, GPIO_NOPULL, GPIO_AF5_SPI2)}, // ARDUINO D12
    {PF_8,  SPI_5, STM_PIN_DATA(STM_MODE_AF_PP, GPIO_NOPULL, GPIO_AF5_SPI5)}, // ARDUINO A3
    {PI_2,  SPI_2, STM_PIN_DATA(STM_MODE_AF_PP, GPIO_NOPULL, GPIO_AF5_SPI2)}, // ARDUINO D8
    {NC,    NC,    0}
};

const PinMap PinMap_SPI_SCLK[] = {
    {PF_7,  SPI_5, STM_PIN_DATA(STM_MODE_AF_PP, GPIO_NOPULL, GPIO_AF5_SPI5)}, // ARDUINO A4
    {PH_6,  SPI_5, STM_PIN_DATA(STM_MODE_AF_PP, GPIO_NOPULL, GPIO_AF5_SPI5)}, // ARDUINO D6
    {PI_1,  SPI_2, STM_PIN_DATA(STM_MODE_AF_PP, GPIO_NOPULL, GPIO_AF5_SPI2)}, // ARDUINO D13
    {NC,    NC,    0}
};

const PinMap PinMap_SPI_SSEL[] = {
    {PB_4,  SPI_2, STM_PIN_DATA(STM_MODE_AF_PP, GPIO_NOPULL, GPIO_AF7_SPI2)}, // ARDUINO D3
    {PB_9,  SPI_2, STM_PIN_DATA(STM_MODE_AF_PP, GPIO_NOPULL, GPIO_AF5_SPI2)}, // ARDUINO D14
    {PF_6,  SPI_5, STM_PIN_DATA(STM_MODE_AF_PP, GPIO_NOPULL, GPIO_AF5_SPI5)}, // ARDUINO A5
    {PI_0,  SPI_2, STM_PIN_DATA(STM_MODE_AF_PP, GPIO_NOPULL, GPIO_AF5_SPI2)}, // ARDUINO D10
    {NC,    NC,    0}
};
