nickmolo/ECE477/(commit log)

2015-09-21 Adding Eagle gitignore and start of schematic
    [SmartWatch.sch]
2015-09-22 adding start of libraries, schematic and board files
    [SmartWatch.brd, SmartWatch.sch]
2015-09-22 adding things to library
    [SmartWatch.brd, SmartWatch.sch]
2015-09-23 adding micro board lbr
2015-09-23 Continued work on schematic and libraries
    [SmartWatch.brd, SmartWatch.sch]
2015-09-23 renamed part
    [SmartWatch.brd, SmartWatch.sch]
2015-09-23 Updated schematic
    [SmartWatch.brd, SmartWatch.sch]
2015-09-23 added to schematic more
    [SmartWatch.brd, SmartWatch.sch]
2015-09-23 created usb part
    [SmartWatch.brd, SmartWatch.sch]
2015-09-26 hardware updates
    [SmartWatch.brd, SmartWatch.sch]
2015-09-26 added almost all parts, changed power management IC
    [SmartWatch.brd, SmartWatch.sch]
2015-09-26 finished schematic!
    [SmartWatch.brd, SmartWatch.sch]
2015-09-26 started board layout
    [SmartWatch.brd, SmartWatch.sch]
2015-09-26 adding stm32cubemx updated fike
2015-09-26 finished PCB and added images
    [SmartWatch.brd]
2015-09-26 cropped image of pcb
2015-09-27 updated with ext programming port also eliminated some gnd loops and added text
    [BOM.xlsx, SmartWatch.brd, SmartWatch.sch]
2015-09-28 added mounting holes
    [SmartWatch.brd, SmartWatch.sch]
2015-09-28 changed mounting holes to pin headers
    [SmartWatch.brd, SmartWatch.sch]
2015-09-29 update board
    [SmartWatch.brd]
2015-09-30 added test points and icreased keepout around bluetooth
    [SmartWatch.brd, SmartWatch.sch]
2015-09-30 updated pcb and bom with test points
    [BOM.xlsx]
2015-10-05 added leds, need to figure out which pins they go to
    [SmartWatch.brd, SmartWatch.sch]
2015-10-07 finished schematic
    [SmartWatch.brd, SmartWatch.sch]
2015-10-07 finished pcb made gerbers
    [SmartWatch.brd, SmartWatch.sch]
2015-10-16 updated PCB to 1.1 and added battery monitoring chip
    [SmartWatch.brd, SmartWatch.sch]
2015-10-16 fixed airwire
    [SmartWatch.brd]
2015-10-21 added decoupling capacitor
    [SmartWatch.brd, SmartWatch.sch]
2015-10-21 added updated cam files
    [SmartWatch.brd]
2015-10-21 updated bom
    [BOM.xlsx, SmartWatch.brd, SmartWatch.sch]
2015-10-23 adding actual gerber files
    [BOM.xlsx, SmartWatch.brd]
2015-10-26 added new cam file and updated gerbers
2015-12-02 adding led test project
    [SmartWatch.dxf]
2015-12-03 more makefiles not working
    [SmartWatch.dxf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]
2015-12-06 adding pdf of schematic
